SFXSoccer/ABCDEFC-Soccer-Robot/EAGLE/Projects 2019/2019 Soccer Robot/Gerber/CAMOutputs/Board 1/GerberFiles/Transcode Report.txt

   ---- Transcoding 'C:\Users\Marc\MEGA\RoboCup\2019\EAGLE\Projects 2019\2019 Soccer Robot\Gerber\CAMOutputs\GerberFiles\copper_top.gbr' ----   Tue Apr 16 15:44:12 2019

D10   --> D100
D11   --> D101
D12   --> D102
D13   --> D103
-----------------------------------------------------------------

   ---- Transcoding 'C:\Users\Marc\MEGA\RoboCup\2019\EAGLE\Projects 2019\2019 Soccer Robot\Gerber\CAMOutputs\GerberFiles\dimensions.gbr' ----   Tue Apr 16 15:44:12 2019

D10   --> D104
-----------------------------------------------------------------

   ---- Transcoding 'C:\Users\Marc\MEGA\RoboCup\2019\EAGLE\Projects 2019\2019 Soccer Robot\Gerber\CAMOutputs\GerberFiles\silkscreen_top.gbr' ----   Tue Apr 16 15:44:15 2019

D10   --> D105
D11   --> D106
D12   --> D107
D13   --> D108
D14   --> D109
D15   --> D110
D16   --> D111
D17   --> D112
D18   --> D113
D19   --> D114
D20   --> D115
D21   --> D116
D22   --> D117
D23   --> D118
D24   --> D119
D25   --> D120
D26   --> D121
-----------------------------------------------------------------

   ---- Transcoding 'C:\Users\Marc\MEGA\RoboCup\2019\EAGLE\Projects 2019\2019 Soccer Robot\Gerber\CAMOutputs\GerberFiles\soldermask_bottom.gbr' ----   Tue Apr 16 15:44:15 2019

D10   --> D122
D11   --> D123
D12   --> D124
D13   --> D125
D14   --> D126
-----------------------------------------------------------------

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

D10   --> D145
D11   --> D146
D12   --> D147
D13   --> D148
-----------------------------------------------------------------
