SFXSoccer/ABCDEFC-Soccer-Robot/EAGLE/Projects 2019/2019 Soccer Robot/Images/Board 1.png

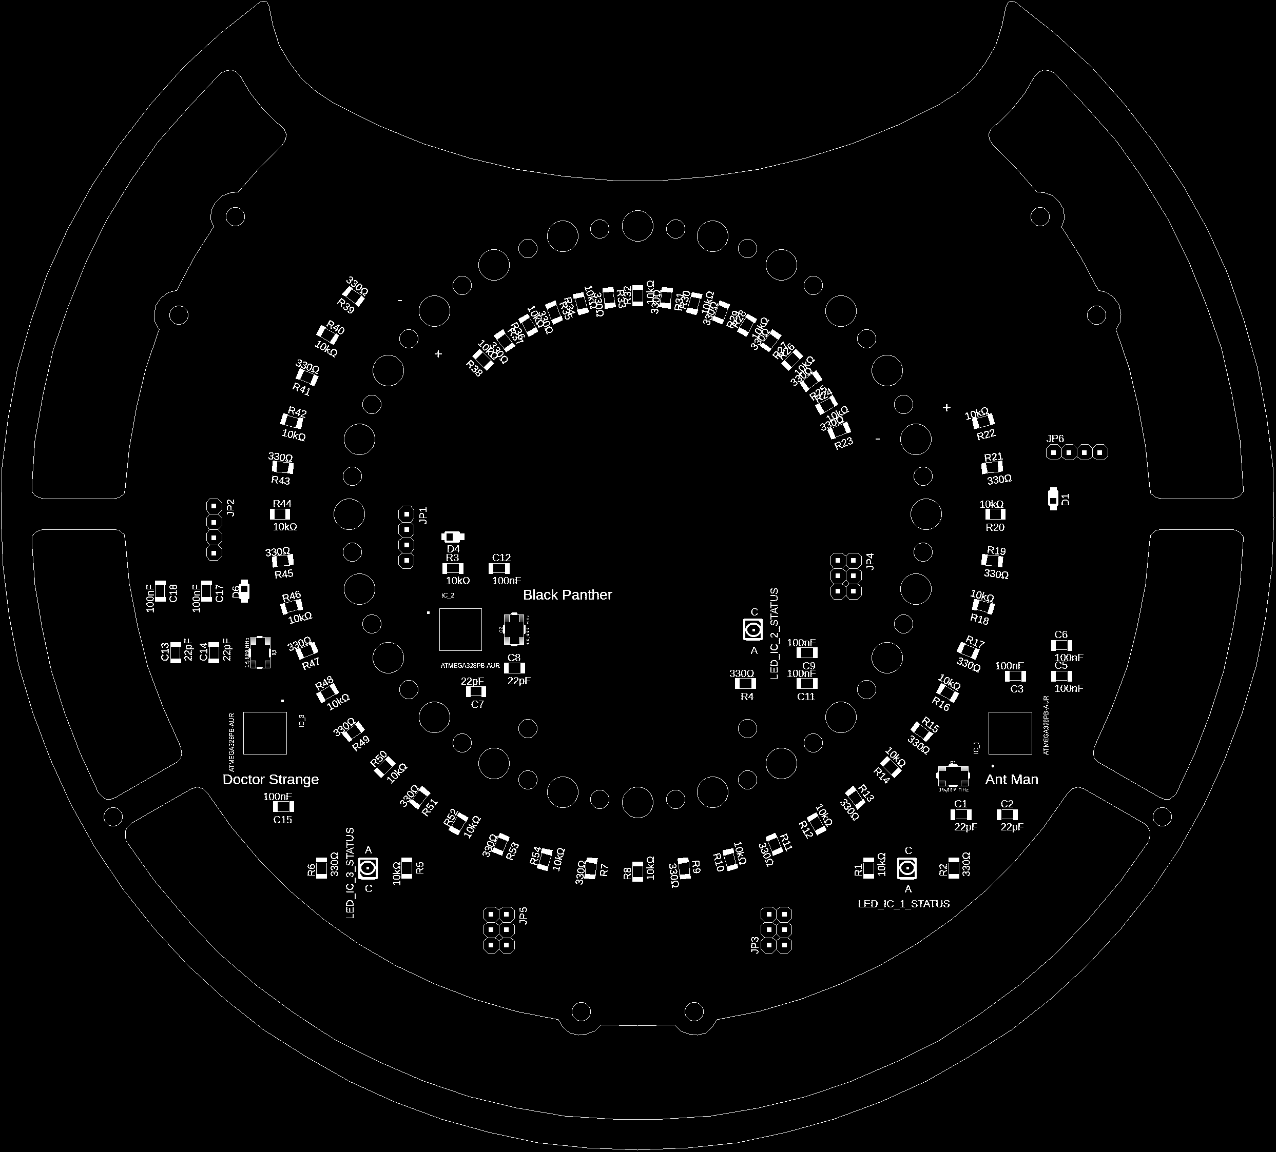
EAGLE/Projects 2019/2019 Soccer Robot/Images/Board 1.png
