SFXSoccer/ABCDEFC-Soccer-Robot/EAGLE/Projects 2019/2019 Soccer Robot/Images/Board 2.png

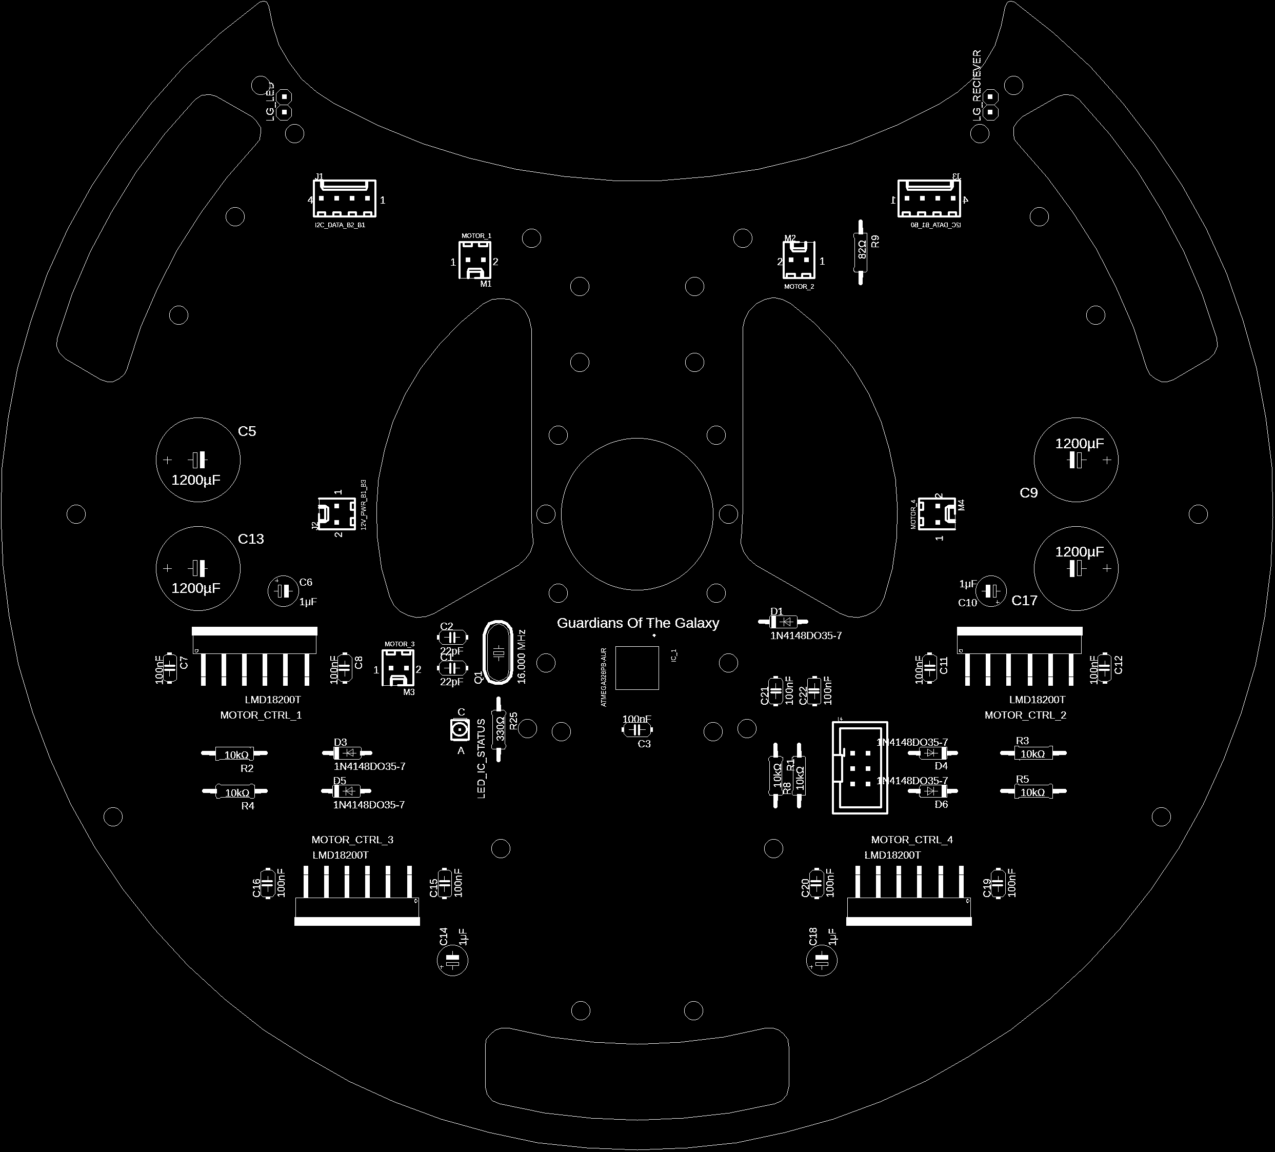
EAGLE/Projects 2019/2019 Soccer Robot/Images/Board 2.png
