SFXSoccer/ABCDEFC-Soccer-Robot/EAGLE/Projects 2019/2019 Soccer Robot/Images/Board 3.png

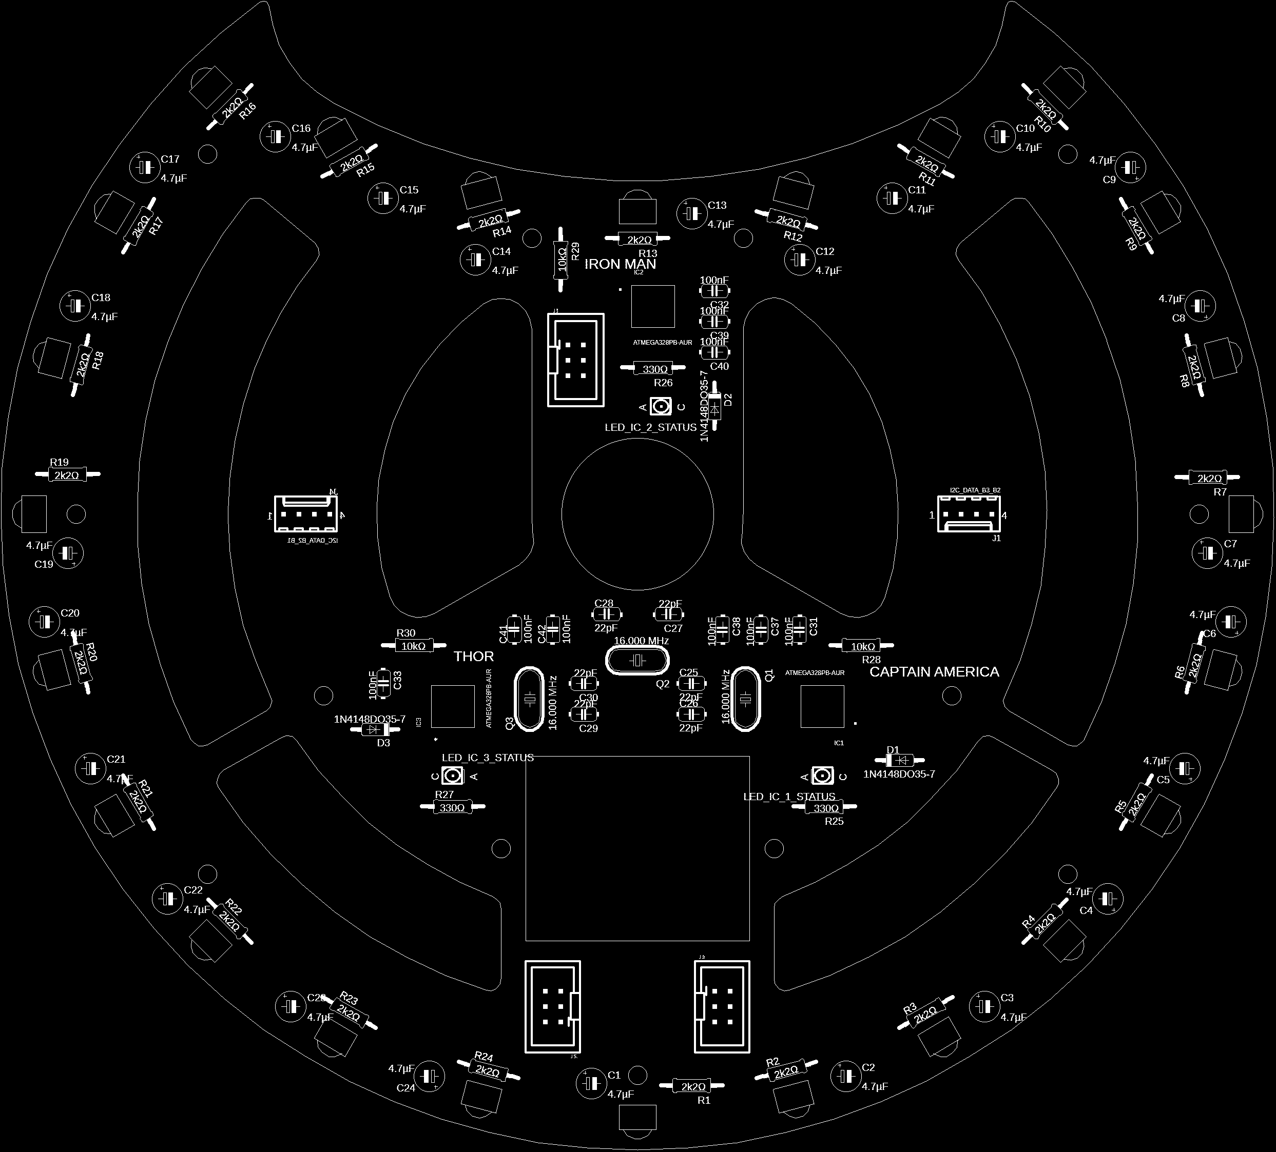
EAGLE/Projects 2019/2019 Soccer Robot/Images/Board 3.png
