SFXSoccer/ABCDEFC-Soccer-Robot/Programming/C#/RobotV2DiagnosticsTool/RobotV2DiagnosticsTool/Assets/Board 1.png

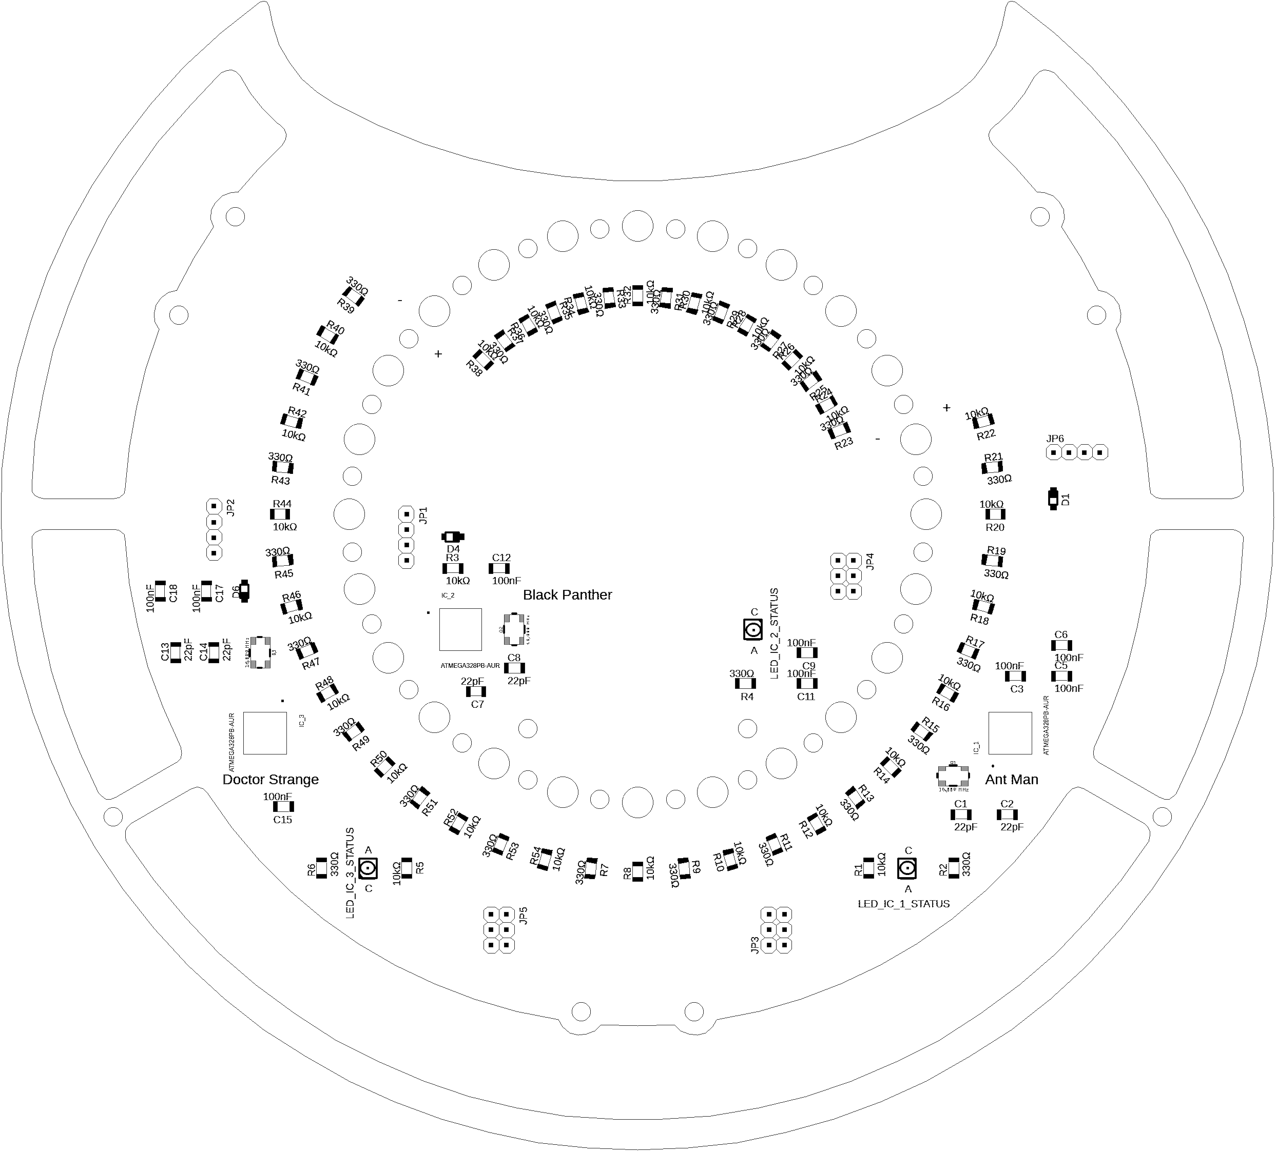
Programming/C#/RobotV2DiagnosticsTool/RobotV2DiagnosticsTool/Assets/Board 1.png
