SFXSoccer/ABCDEFC-Soccer-Robot/Programming/C#/RobotV2DiagnosticsTool/RobotV2DiagnosticsTool/Assets/Board 3.png

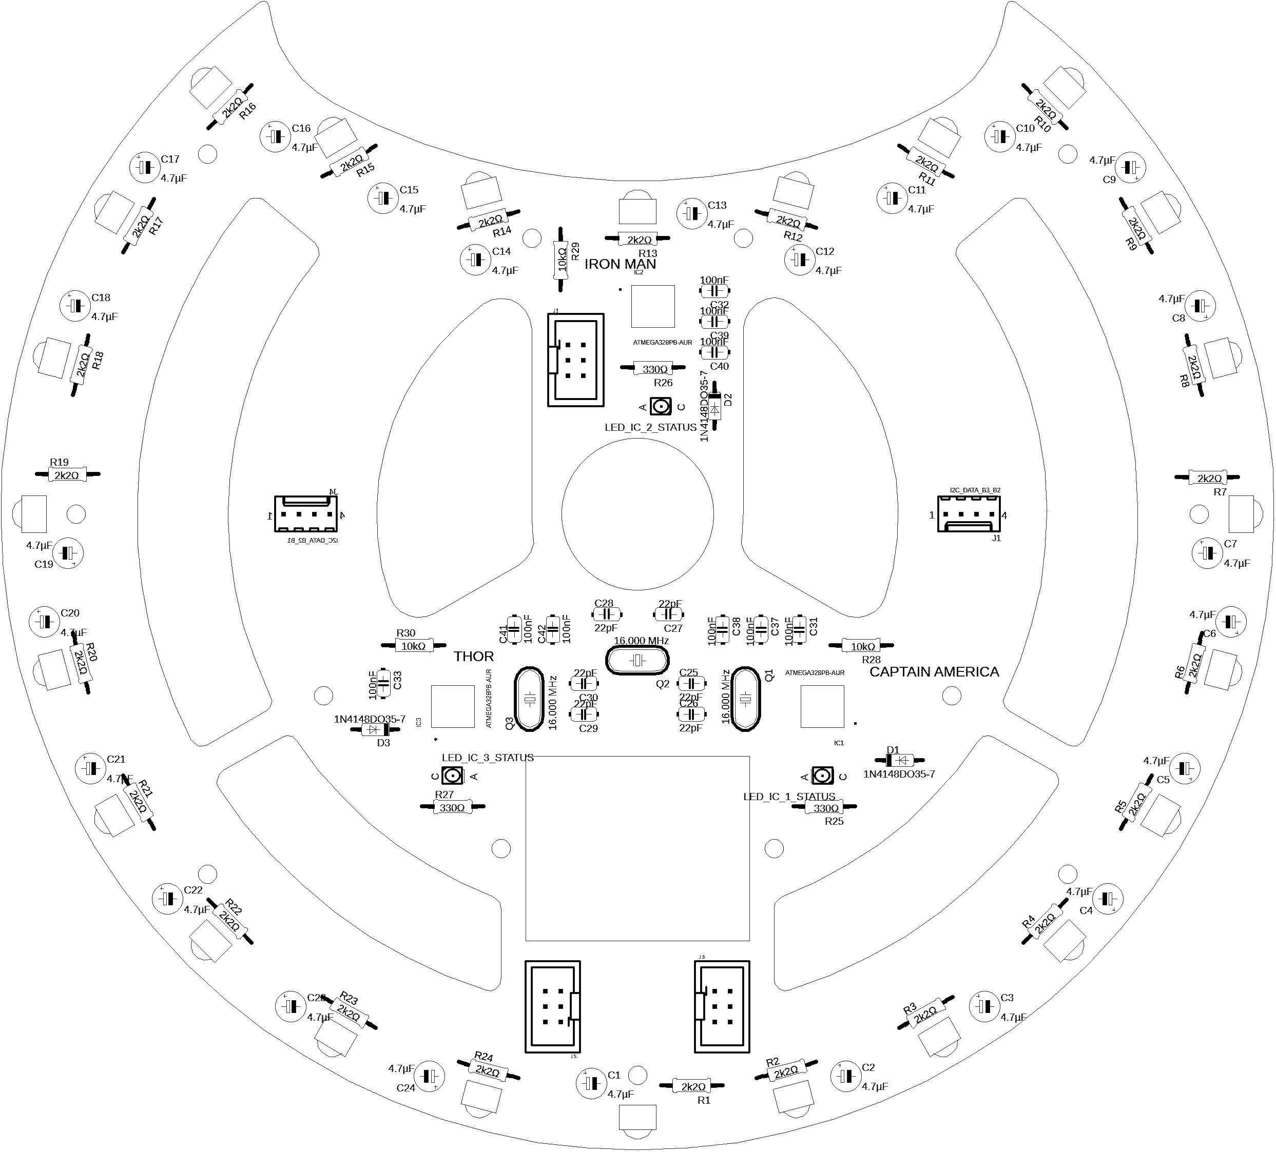
Programming/C#/RobotV2DiagnosticsTool/RobotV2DiagnosticsTool/Assets/Board 3.png
