SFXSoccer/ABCDEFC-Soccer-Robot/Programming/C#/RobotV2DiagnosticsTool/RobotV2DiagnosticsTool/Assets/Robot.png

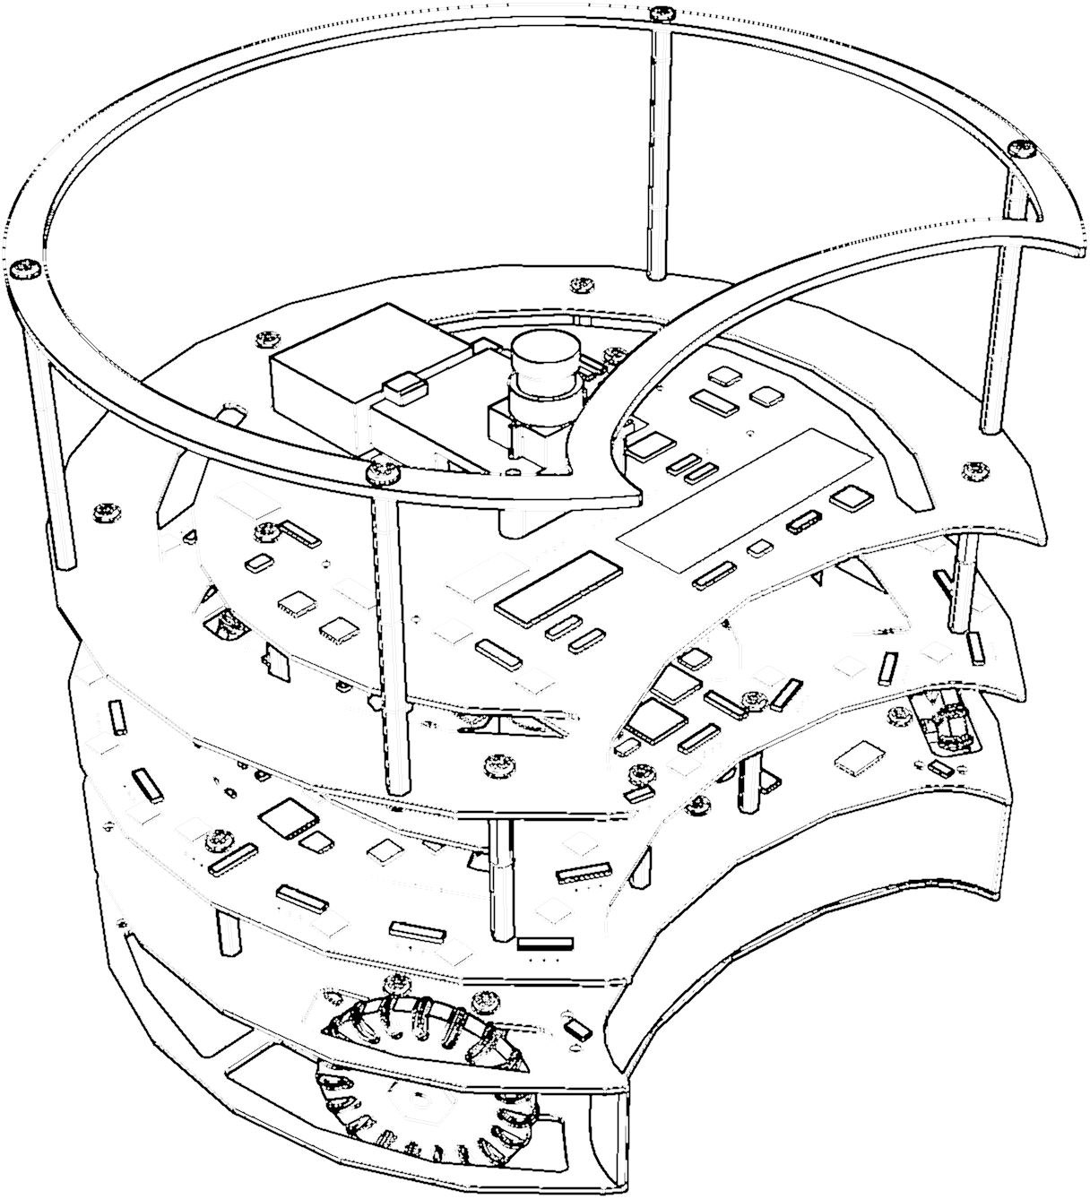
Programming/C#/RobotV2DiagnosticsTool/RobotV2DiagnosticsTool/Assets/Robot.png
