SFXSoccer/ABCDEFC-Soccer-Robot/EAGLE/DXF Files/Board 1.dxf

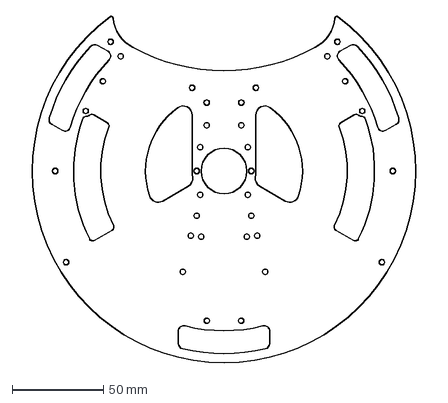
[picture p11: CAD file, 2019-07-01]
EAGLE/DXF Files/Board 1.dxf
227.8 x 189.7 mm
