SFXSoccer/ABCDEFC-Soccer-Robot/EAGLE/DXF Files/Board 0.dxf

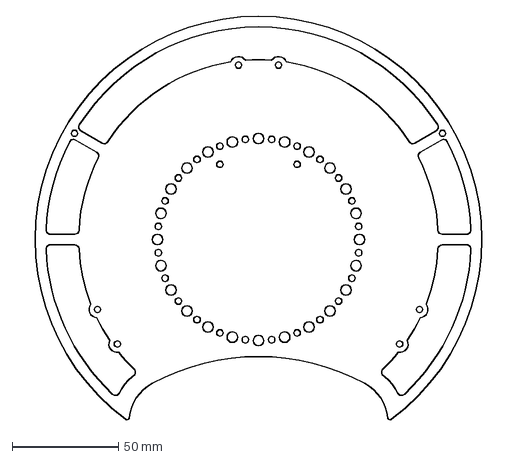
[picture p12: CAD file, 2019-07-01]
EAGLE/DXF Files/Board 0.dxf
227.8 x 189.7 mm
