SFXSoccer/ABCDEFC-Soccer-Robot/EAGLE/DXF Files/Camera PCB.dxf

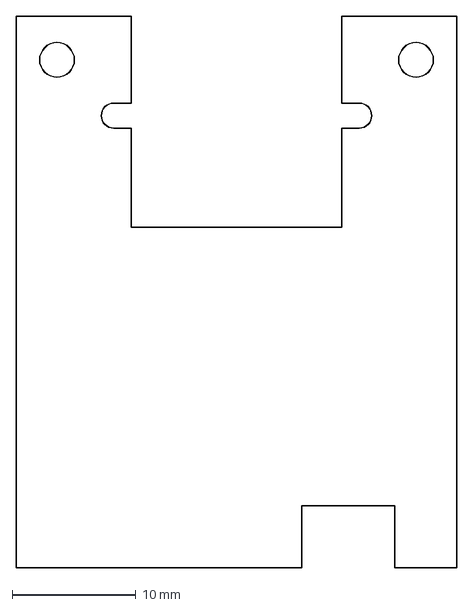
[picture p13: CAD file, 2019-07-01]
EAGLE/DXF Files/Camera PCB.dxf
35.6 x 44.5 mm
