SFXSoccer/ABCDEFC-Soccer-Robot/EAGLE/DXF Files/Camera Sensor Base.dxf

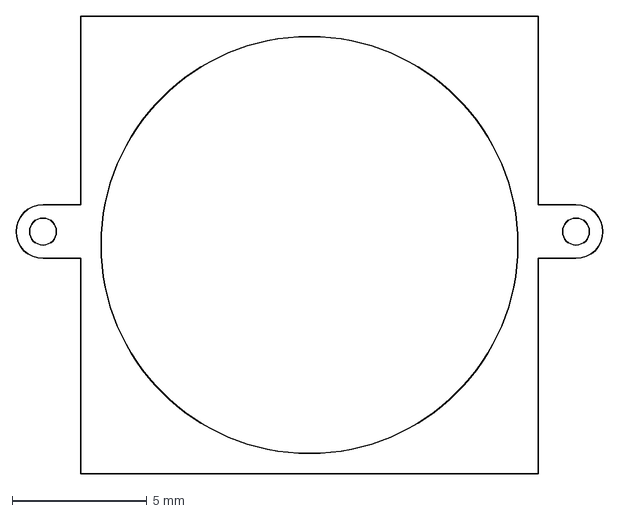
[picture p14: CAD file, 2019-07-01]
EAGLE/DXF Files/Camera Sensor Base.dxf
21.8 x 17.0 mm
