SFXSoccer/ABCDEFC-Soccer-Robot/EAGLE/DXF Files/Kicker Motor Mount.dxf

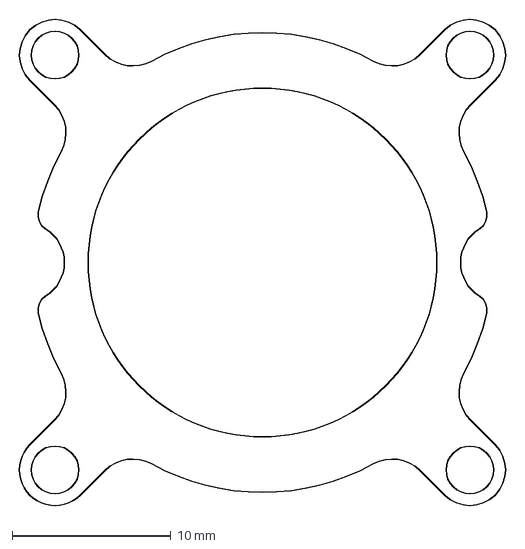
[picture p15: CAD file, 2019-07-01]
EAGLE/DXF Files/Kicker Motor Mount.dxf
31.1 x 31.1 mm
