SFXSoccer/ABCDEFC-Soccer-Robot/EAGLE/DXF Files/Battery Holder Base.dxf

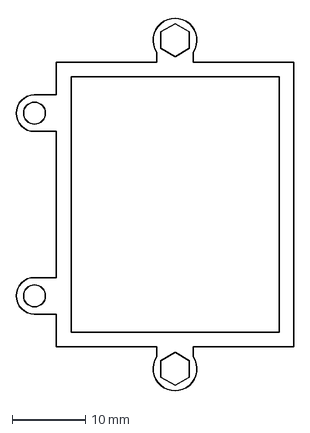
[picture p16: CAD file, 2019-07-01]
EAGLE/DXF Files/Battery Holder Base.dxf
38.0 x 51.5 mm
