SFXSoccer/ABCDEFC-Soccer-Robot/EAGLE/DXF Files/Board 2.dxf

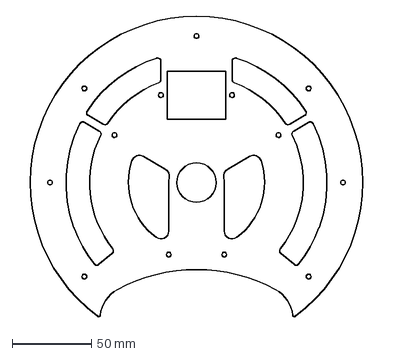
[picture p17: CAD file, 2019-07-01]
EAGLE/DXF Files/Board 2.dxf
227.8 x 189.7 mm
