SFXSoccer/ABCDEFC-Soccer-Robot/(list of files, cad)

Other CAD files:
EAGLE/Projects 2019/2019 Soccer Robot/IDF/Board 1/1X04SMD, JP1_1X04SMD_27.ipt
EAGLE/Projects 2019/2019 Soccer Robot/IDF/Board 1/1X04SMD, JP2_1X04SMD_29.ipt
EAGLE/Projects 2019/2019 Soccer Robot/IDF/Board 1/1X04SMD, JP6_1X04SMD_37.ipt
EAGLE/Projects 2019/2019 Soccer Robot/IDF/Board 1/2X03SMD, JP3_2X03SMD_31.ipt
EAGLE/Projects 2019/2019 Soccer Robot/IDF/Board 1/2X03SMD, JP4_2X03SMD_33.ipt
EAGLE/Projects 2019/2019 Soccer Robot/IDF/Board 1/2X03SMD, JP5_2X03SMD_35.ipt
EAGLE/Projects 2019/2019 Soccer Robot/IDF/Board 1/Board 0.brd.iam
EAGLE/Projects 2019/2019 Soccer Robot/IDF/Board 1/Board 0.brd_Outline.ipt
EAGLE/Projects 2019/2019 Soccer Robot/IDF/Board 1/C1206, C1206_1.ipt
EAGLE/Projects 2019/2019 Soccer Robot/IDF/Board 1/CRYSTAL-SMD-5X3_2-4PAD, 16_000_95.ipt
EAGLE/Projects 2019/2019 Soccer Robot/IDF/Board 1/P-LCC-2, LED_IC_1_STATUS_P-LCC-2_39.ipt
EAGLE/Projects 2019/2019 Soccer Robot/IDF/Board 1/P-LCC-2, LED_IC_2_STATUS_P-LCC-2_41.ipt
EAGLE/Projects 2019/2019 Soccer Robot/IDF/Board 1/P-LCC-2, LED_IC_3_STATUS_P-LCC-2_43.ipt
EAGLE/Projects 2019/2019 Soccer Robot/IDF/Board 1/QFP80P900X900X120-32N, ATMEGA328PB-AUR_23.ipt
EAGLE/Projects 2019/2019 Soccer Robot/IDF/Board 1/R1206, R1206_99.ipt
EAGLE/Projects 2019/2019 Soccer Robot/IDF/Board 1/SMD_LED_3MM, SMD_LED_3MM_45.ipt
EAGLE/Projects 2019/2019 Soccer Robot/IDF/Board 1/SMD_PHOTORESISTOR_5MM, SMD_PHOTORESISTOR_5MM_70.ipt
EAGLE/Projects 2019/2019 Soccer Robot/IDF/Board 1/SOD123, D1_SOD123_17.ipt
EAGLE/Projects 2019/2019 Soccer Robot/IDF/Board 1/SOD123, D4_SOD123_19.ipt
EAGLE/Projects 2019/2019 Soccer Robot/IDF/Board 1/SOD123, D6_SOD123_21.ipt
EAGLE/Projects 2019/2019 Soccer Robot/IDF/Board 2/0207_10, 0207_10_61.ipt
EAGLE/Projects 2019/2019 Soccer Robot/IDF/Board 2/1X02, 1X02_43.ipt
EAGLE/Projects 2019/2019 Soccer Robot/IDF/Board 2/2X3-SHROUDED, J4_2X3-SHROUDED_39.ipt
EAGLE/Projects 2019/2019 Soccer Robot/IDF/Board 2/6410-02, 12V_PWR_B1_B3_35.ipt
EAGLE/Projects 2019/2019 Soccer Robot/IDF/Board 2/6410-02, MOTOR_1_46.ipt
EAGLE/Projects 2019/2019 Soccer Robot/IDF/Board 2/6410-02, MOTOR_2_48.ipt
EAGLE/Projects 2019/2019 Soccer Robot/IDF/Board 2/6410-02, MOTOR_3_50.ipt
EAGLE/Projects 2019/2019 Soccer Robot/IDF/Board 2/6410-02, MOTOR_4_52.ipt
EAGLE/Projects 2019/2019 Soccer Robot/IDF/Board 2/6410-04, I2C_DATA_B1_B0_37.ipt
EAGLE/Projects 2019/2019 Soccer Robot/IDF/Board 2/6410-04, I2C_DATA_B2_B1_33.ipt
EAGLE/Projects 2019/2019 Soccer Robot/IDF/Board 2/Board 1.brd.iam
EAGLE/Projects 2019/2019 Soccer Robot/IDF/Board 2/Board 1.brd_Outline.ipt
EAGLE/Projects 2019/2019 Soccer Robot/IDF/Board 2/C050-024X044, C050-024X044_1.ipt
EAGLE/Projects 2019/2019 Soccer Robot/IDF/Board 2/DO35-7, 1N4148DO35-7_25.ipt
EAGLE/Projects 2019/2019 Soccer Robot/IDF/Board 2/E2-5, E2-5_7.ipt
EAGLE/Projects 2019/2019 Soccer Robot/IDF/Board 2/E5-13, E5-13_5.ipt
EAGLE/Projects 2019/2019 Soccer Robot/IDF/Board 2/HC49U-V, 16_000_59.ipt
EAGLE/Projects 2019/2019 Soccer Robot/IDF/Board 2/P-LCC-2, LED_IC_STATUS_P-LCC-2_41.ipt
EAGLE/Projects 2019/2019 Soccer Robot/IDF/Board 2/QFP80P900X900X120-32N, ATMEGA328PB-AUR_31.ipt
EAGLE/Projects 2019/2019 Soccer Robot/IDF/Board 2/TO-220-11, LMD18200T_54.ipt
EAGLE/Projects 2019/2019 Soccer Robot/IDF/Board 3/0207_10, 0207_10_70.ipt
EAGLE/Projects 2019/2019 Soccer Robot/IDF/Board 3/2X3-SHROUDED, J2_2X3-SHROUDED_52.ipt
EAGLE/Projects 2019/2019 Soccer Robot/IDF/Board 3/2X3-SHROUDED, J3_2X3-SHROUDED_54.ipt
EAGLE/Projects 2019/2019 Soccer Robot/IDF/Board 3/2X3-SHROUDED, J5_2X3-SHROUDED_58.ipt
EAGLE/Projects 2019/2019 Soccer Robot/IDF/Board 3/6410-04, I2C_DATA_B2_B1_56.ipt
EAGLE/Projects 2019/2019 Soccer Robot/IDF/Board 3/6410-04, I2C_DATA_B3_B2_50.ipt
EAGLE/Projects 2019/2019 Soccer Robot/IDF/Board 3/Board 2.brd.iam
EAGLE/Projects 2019/2019 Soccer Robot/IDF/Board 3/Board 2.brd_Outline.ipt
EAGLE/Projects 2019/2019 Soccer Robot/IDF/Board 3/C050-024X044, C050-024X044_26.ipt
EAGLE/Projects 2019/2019 Soccer Robot/IDF/Board 3/DO35-7, 1N4148DO35-7_42.ipt
EAGLE/Projects 2019/2019 Soccer Robot/IDF/Board 3/E2-5, E2-5_1.ipt
EAGLE/Projects 2019/2019 Soccer Robot/IDF/Board 3/HC49U-V, 16_000_66.ipt
EAGLE/Projects 2019/2019 Soccer Robot/IDF/Board 3/P-LCC-2, LED_IC_1_STATUS_P-LCC-2_60.ipt
EAGLE/Projects 2019/2019 Soccer Robot/IDF/Board 3/P-LCC-2, LED_IC_2_STATUS_P-LCC-2_62.ipt
EAGLE/Projects 2019/2019 Soccer Robot/IDF/Board 3/P-LCC-2, LED_IC_3_STATUS_P-LCC-2_64.ipt
EAGLE/Projects 2019/2019 Soccer Robot/IDF/Board 3/QFP80P900X900X120-32N, ATMEGA328PB-AUR_46.ipt
EAGLE/Projects 2019/2019 Soccer Robot/IDF/Board 3/TSOP143XX, TSOP14340_101.ipt
EAGLE/Projects 2019/2019 Soccer Robot/IDF/Board 4/0207_10, 0207_10_44.ipt
EAGLE/Projects 2019/2019 Soccer Robot/IDF/Board 4/0207_9, 10K_50.ipt
EAGLE/Projects 2019/2019 Soccer Robot/IDF/Board 4/0207_9, 4K7_47.ipt
EAGLE/Projects 2019/2019 Soccer Robot/IDF/Board 4/1X04, 1X04_17.ipt
EAGLE/Projects 2019/2019 Soccer Robot/IDF/Board 4/1X08, 1X08_14.ipt
EAGLE/Projects 2019/2019 Soccer Robot/IDF/Board 4/6410-02, 12V_POWER_32.ipt
EAGLE/Projects 2019/2019 Soccer Robot/IDF/Board 4/6410-02, KICKER_ENCODER_36.ipt
EAGLE/Projects 2019/2019 Soccer Robot/IDF/Board 4/6410-04, I2C_DATA_B3_B2_28.ipt
EAGLE/Projects 2019/2019 Soccer Robot/IDF/Board 4/6410-04, LIDAR_34.ipt
EAGLE/Projects 2019/2019 Soccer Robot/IDF/Board 4/6410-04, MAG_ACC_I2C_26.ipt
EAGLE/Projects 2019/2019 Soccer Robot/IDF/Board 4/6410-05, LED_MATRIX_30.ipt
EAGLE/Projects 2019/2019 Soccer Robot/IDF/Board 4/78XXS, IC1_78XXS_22.ipt
EAGLE/Projects 2019/2019 Soccer Robot/IDF/Board 4/78XXS, IC2_78XXS_24.ipt
EAGLE/Projects 2019/2019 Soccer Robot/IDF/Board 4/B3F-10XX, BUTTON0_B3F-10XX_1.ipt
EAGLE/Projects 2019/2019 Soccer Robot/IDF/Board 4/B3F-10XX, BUTTON1_B3F-10XX_3.ipt
EAGLE/Projects 2019/2019 Soccer Robot/IDF/Board 4/B3F-10XX, BUTTON2_B3F-10XX_5.ipt
EAGLE/Projects 2019/2019 Soccer Robot/IDF/Board 4/B3F-10XX, BUTTON3_B3F-10XX_7.ipt
EAGLE/Projects 2019/2019 Soccer Robot/IDF/Board 4/B3F-10XX, RESET_B3F-10XX_57.ipt
EAGLE/Projects 2019/2019 Soccer Robot/IDF/Board 4/Board 3 Teensy.brd.iam
EAGLE/Projects 2019/2019 Soccer Robot/IDF/Board 4/Board 3 Teensy.brd_Outline.ipt
EAGLE/Projects 2019/2019 Soccer Robot/IDF/Board 4/DO35-7, 1N4148DO35-7_19.ipt
EAGLE/Projects 2019/2019 Soccer Robot/IDF/Board 4/E2-5, E2-5_9.ipt
EAGLE/Projects 2019/2019 Soccer Robot/IDF/Board 4/OldVersions/Board 3 Teensy.brd.0001.iam
EAGLE/Projects 2019/2019 Soccer Robot/IDF/Board 4/P-LCC-2, LED_5V_0_P-LCC-2_38.ipt
EAGLE/Projects 2019/2019 Soccer Robot/IDF/Board 4/P-LCC-2, LED_5V_1_P-LCC-2_40.ipt
EAGLE/Projects 2019/2019 Soccer Robot/IDF/Board 4/P-LCC-2, LED_IC_1_STATUS_P-LCC-2_42.ipt
EAGLE/Projects 2019/2019 Soccer Robot/IDF/Board 4/SCHALTER, SCHALTER_68.ipt
EAGLE/Projects 2019/2019 Soccer Robot/IDF/Board 4/SICHERUNG, SICHERUNG_59.ipt
EAGLE/Projects 2019/2019 Soccer Robot/IDF/Board 4/STAND-OFF, STAND-OFF_65.ipt
EAGLE/Projects 2019/2019 Soccer Robot/IDF/Board 4/TEENSY_3_5_ALL_PINS, TEENSY_3_5_ALL_PINS_63.ipt
EAGLE/Projects 2019/2019 Soccer Robot/IDF/Board 4/XT60, XT60_61.ipt
Inventor/15mmStandoff.ipt
Inventor/19mmStandoff.ipt
Inventor/1stPlate.ipt
Inventor/2ndPlate.ipt
Inventor/2x6mmScrew.ipt
Inventor/3rdFront.ipt
Inventor/3rdPlate.ipt
Inventor/3rdShroud.ipt
Inventor/4thPlate.ipt
Inventor/50mm OmniWheel Mockup.ipt
Inventor/5mmScrew.ipt
Inventor/730RPM Motor Mockup.ipt
Inventor/8mmStandoff.ipt
Inventor/Handle.ipt
Inventor/IRShroudV2.ipt
Inventor/LightGate.ipt
Inventor/MirrorMountTest.ipt
Inventor/Motor&MotorMount.iam
Inventor/MotorMountv2.ipt
Inventor/OldVersions/IRShroudV2.0001.ipt
Inventor/OldVersions/WholeRobotAssembly.0002.iam
Inventor/WholeRobotAssembly.iam
