SFXSoccer/ABCDEFC-Soccer-Robot/EAGLE/Projects 2019/2019 Soccer Robot/Board 2.brd

## EAGLE design EAGLE/Projects 2019/2019 Soccer Robot/Board 2.brd (2019-07-01)

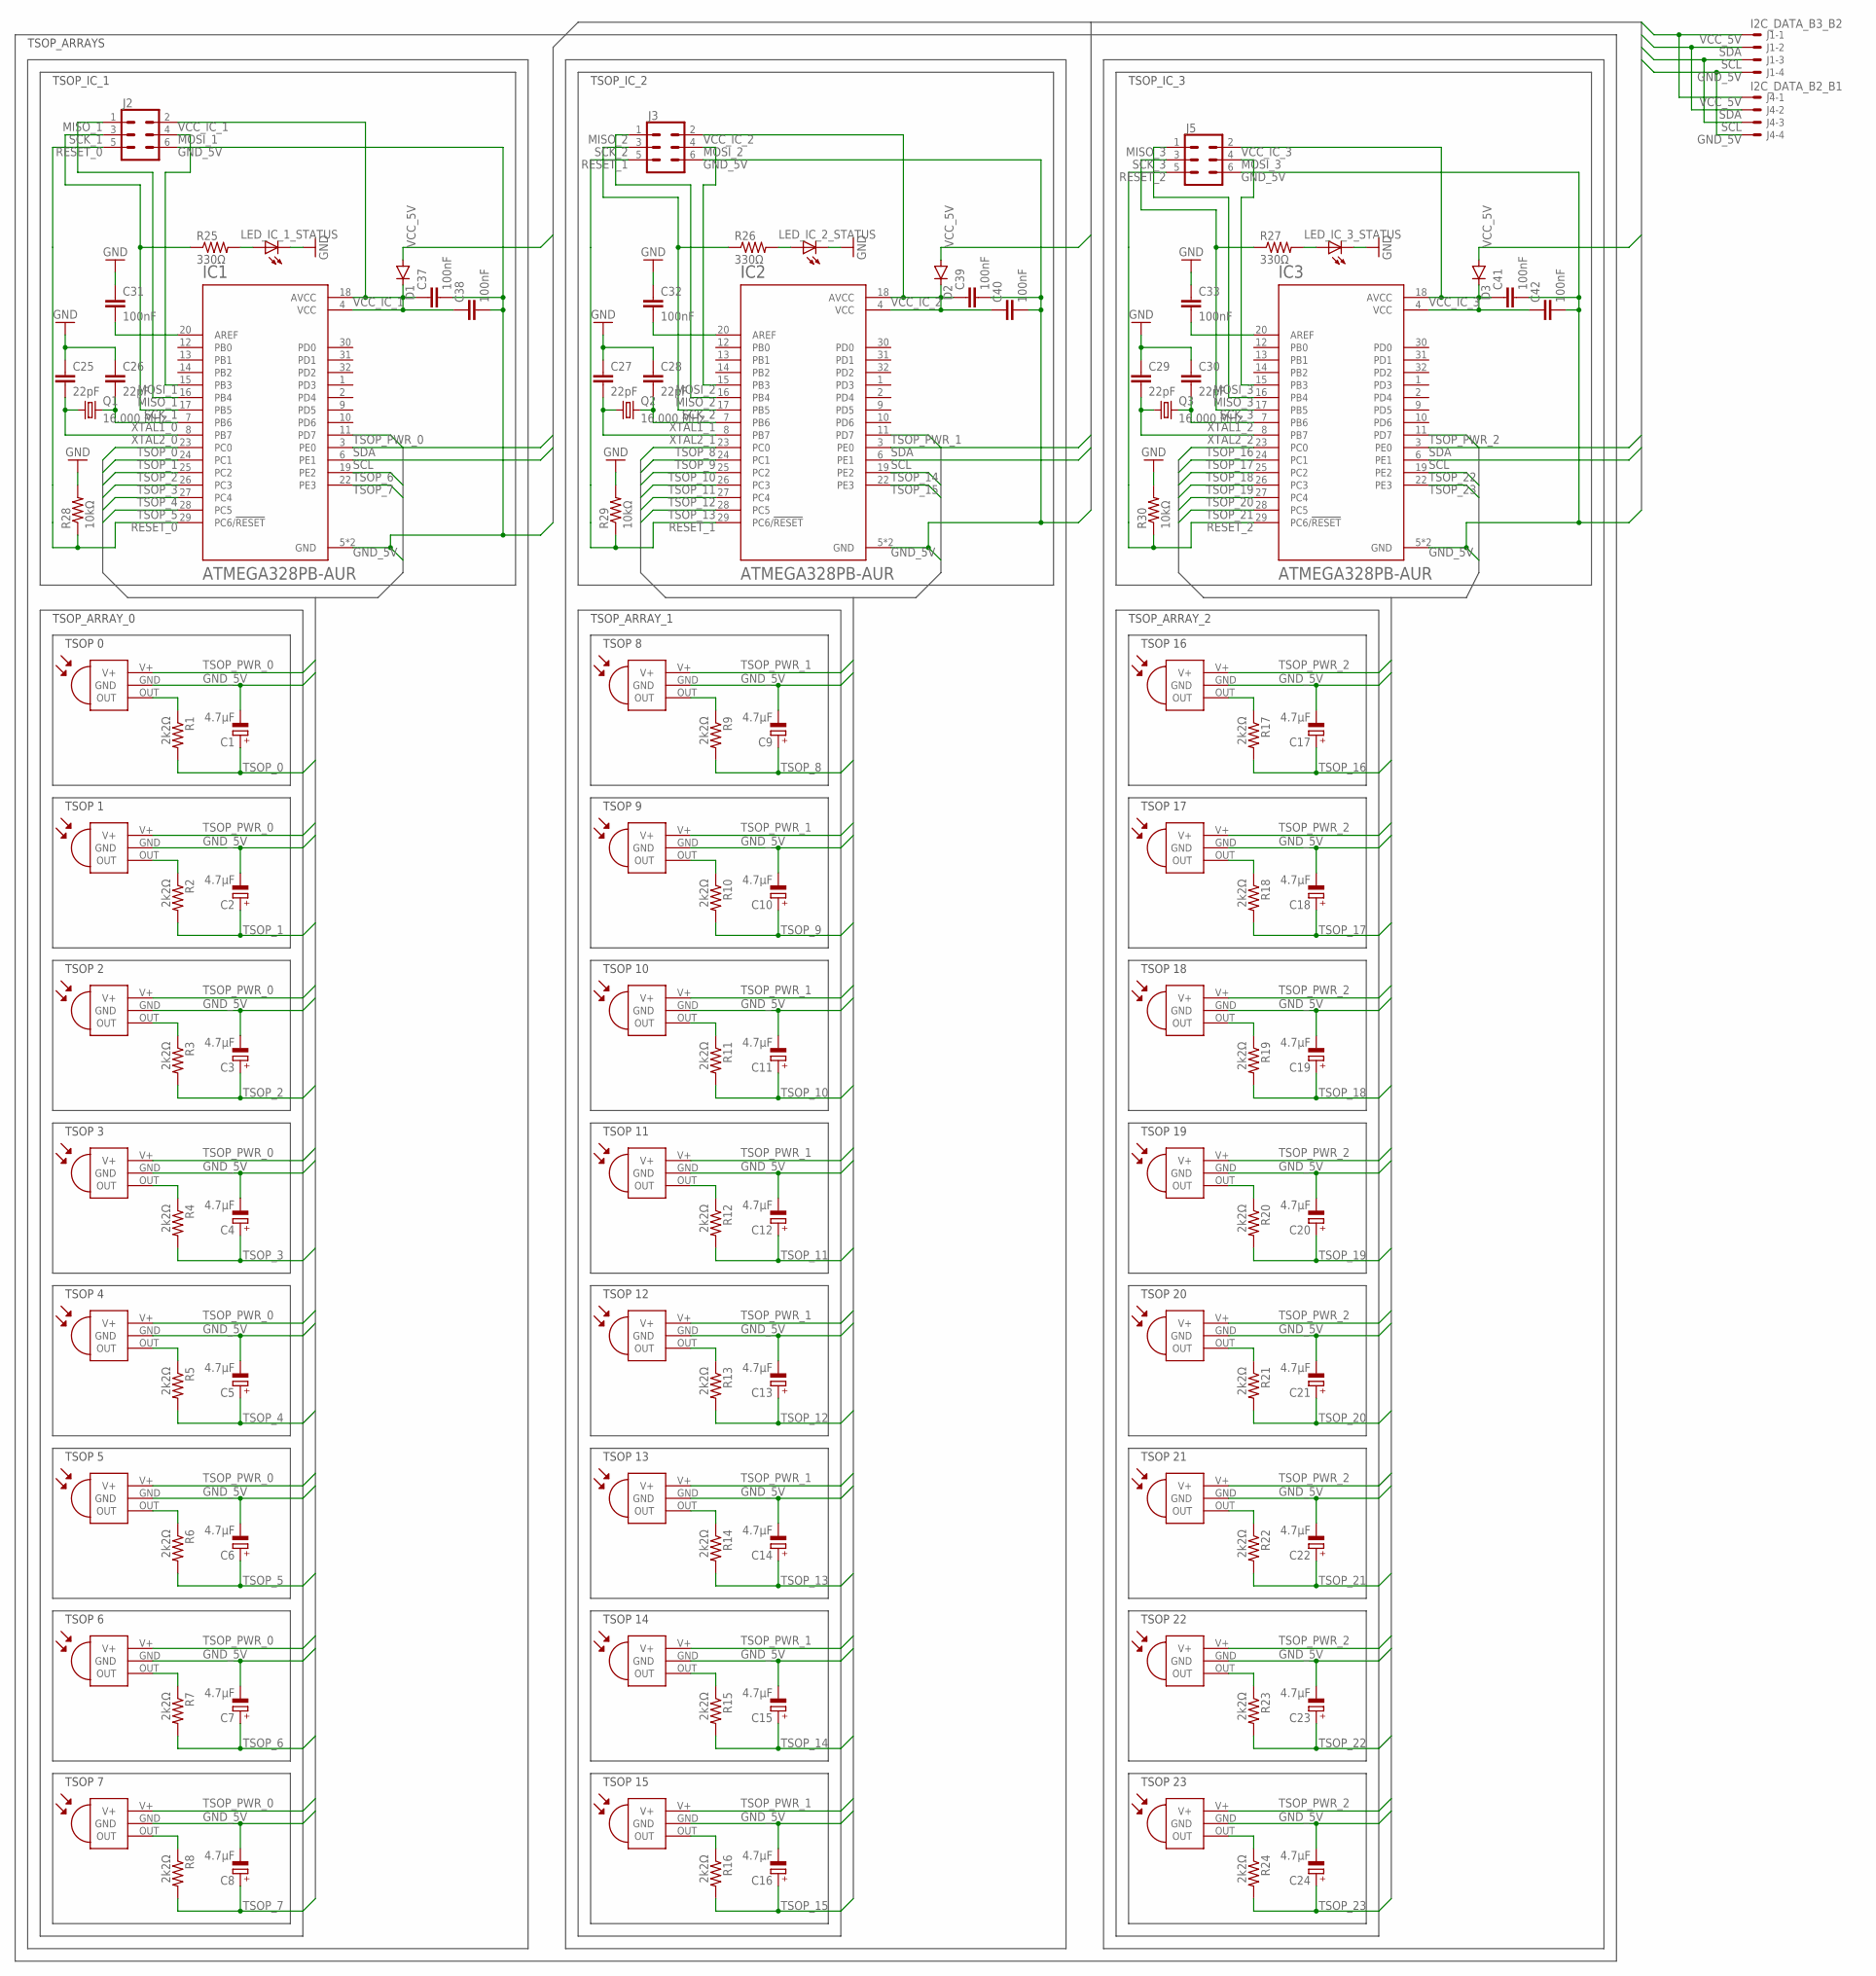
[picture p18: schematic Board 2.sch]

Parts:
C1, C2, C3, C4, C5, C6, C7, C8, C9, C10, C11, C12, C13, C14, C15, C16, C17, C18, C19, C20, C21, C22, C23, C24: 4.7µF; E2-5
C25, C26, C27, C28, C29, C30: 22pF; C050-024X044
C31, C32, C33, C37, C38, C39, C40, C41, C42: 100nF; C050-024X044
D1, D2, D3: 1N4148DO35-7; DO35-7
IC1, IC2, IC3: ATMEGA328PB-AUR; QFP80P900X900X120-32N
J1: I2C_DATA_B3_B2; 6410-04
J2, J3, J5: CONN_03X2SHROUD; 2X3-SHROUDED
J4: I2C_DATA_B2_B1; 6410-04
LED_IC_1_STATUS, LED_IC_2_STATUS, LED_IC_3_STATUS: LEDP-LCC-2; P-LCC-2
Q1, Q2, Q3: 16.000 MHz; HC49U-V
R1, R2, R3, R4, R5, R6, R7, R8, R9, R10, R11, R12, R13, R14, R15, R16, R17, R18, R19, R20, R21, R22, R23, R24: 2k2Ω; 0207/10
R25, R26, R27: 330Ω; 0207/10
R28, R29, R30: 10kΩ; 0207/10
TSOP_1, TSOP_2, TSOP_3, TSOP_4, TSOP_5, TSOP_6, TSOP_7, TSOP_8, TSOP_9, TSOP_10, TSOP_11, TSOP_12, TSOP_13, TSOP_14, TSOP_15, TSOP_16, TSOP_17, TSOP_18, TSOP_19, TSOP_20, TSOP_21, TSOP_22, TSOP_23, TSOP_24: TSOP14340; TSOP143XX

Connections:
GND_5V: C1.-, C2.-, C3.-, C4.-, C5.-, C6.-, C7.-, C8.-, C9.-, C10.-, C11.-, C12.-, C13.-, C14.-, C15.-, C16.-, C17.-, C18.-, C19.-, C20.-, C21.-, C22.-, C23.-, C24.-, C25.1, C26.1, C27.1, C28.1, C29.1, C30.1, C31.1, C32.1, C33.1, C37.2, C38.2, C39.2, C40.2, C41.2, C42.2, IC1.5 (GND), IC1.21 (GND), IC2.5 (GND), IC2.21 (GND), IC3.5 (GND), IC3.21 (GND), J1.4, J2.6, J3.6, J4.4, J5.6, LED_IC_1_STATUS.C, LED_IC_2_STATUS.C, LED_IC_3_STATUS.C, R28.2, R29.2, R30.2, TSOP_1.GND, TSOP_2.GND, TSOP_3.GND, TSOP_4.GND, TSOP_5.GND, TSOP_6.GND, TSOP_7.GND, TSOP_8.GND, TSOP_9.GND, TSOP_10.GND, TSOP_11.GND, TSOP_12.GND, TSOP_13.GND, TSOP_14.GND, TSOP_15.GND, TSOP_16.GND, TSOP_17.GND, TSOP_18.GND, TSOP_19.GND, TSOP_20.GND, TSOP_21.GND, TSOP_22.GND, TSOP_23.GND, TSOP_24.GND
MISO_1: IC1.16 (PB4), J2.1
MISO_2: IC2.16 (PB4), J3.1
MISO_3: IC3.16 (PB4), J5.1
MOSI_1: IC1.15 (PB3), J2.4
MOSI_2: IC2.15 (PB3), J3.4
MOSI_3: IC3.15 (PB3), J5.4
unnamed: R1.1, TSOP_1.OUT
unnamed: R2.1, TSOP_2.OUT
unnamed: R3.1, TSOP_3.OUT
unnamed: R4.1, TSOP_4.OUT
unnamed: R5.1, TSOP_5.OUT
unnamed: R6.1, TSOP_6.OUT
unnamed: R7.1, TSOP_7.OUT
unnamed: R8.1, TSOP_8.OUT
unnamed: R9.1, TSOP_9.OUT
unnamed: R10.1, TSOP_10.OUT
unnamed: R11.1, TSOP_11.OUT
unnamed: R12.1, TSOP_12.OUT
unnamed: R13.1, TSOP_13.OUT
unnamed: R14.1, TSOP_14.OUT
unnamed: R15.1, TSOP_15.OUT
unnamed: R16.1, TSOP_16.OUT
unnamed: R17.1, TSOP_17.OUT
unnamed: R18.1, TSOP_18.OUT
unnamed: R19.1, TSOP_19.OUT
unnamed: R20.1, TSOP_20.OUT
unnamed: R21.1, TSOP_21.OUT
unnamed: R22.1, TSOP_22.OUT
unnamed: R23.1, TSOP_23.OUT
unnamed: R24.1, TSOP_24.OUT
unnamed: LED_IC_1_STATUS.A, R25.2
unnamed: C31.2, IC1.20 (AREF)
unnamed: LED_IC_2_STATUS.A, R26.2
unnamed: C32.2, IC2.20 (AREF)
unnamed: LED_IC_3_STATUS.A, R27.2
unnamed: C33.2, IC3.20 (AREF)
RESET_0: IC1.29 (PC6/!RESET), J2.5, R28.1
RESET_1: IC2.29 (PC6/!RESET), J3.5, R29.1
RESET_2: IC3.29 (PC6/!RESET), J5.5, R30.1
SCK_1: IC1.17 (PB5), J2.3, R25.1
SCK_2: IC2.17 (PB5), J3.3, R26.1
SCK_3: IC3.17 (PB5), J5.3, R27.1
SCL: IC1.6 (PE1), IC2.6 (PE1), IC3.6 (PE1), J1.3, J4.3
SDA: IC1.3 (PE0), IC2.3 (PE0), IC3.3 (PE0), J1.2, J4.2
TSOP_0: C1.+, IC1.23 (PC0), R1.2
TSOP_1: C2.+, IC1.24 (PC1), R2.2
TSOP_2: C3.+, IC1.25 (PC2), R3.2
TSOP_3: C4.+, IC1.26 (PC3), R4.2
TSOP_4: C5.+, IC1.27 (PC4), R5.2
TSOP_5: C6.+, IC1.28 (PC5), R6.2
TSOP_6: C7.+, IC1.19 (PE2), R7.2
TSOP_7: C8.+, IC1.22 (PE3), R8.2
TSOP_8: C9.+, IC2.23 (PC0), R9.2
TSOP_9: C10.+, IC2.24 (PC1), R10.2
TSOP_10: C11.+, IC2.25 (PC2), R11.2
TSOP_11: C12.+, IC2.26 (PC3), R12.2
TSOP_12: C13.+, IC2.27 (PC4), R13.2
TSOP_13: C14.+, IC2.28 (PC5), R14.2
TSOP_14: C15.+, IC2.19 (PE2), R15.2
TSOP_15: C16.+, IC2.22 (PE3), R16.2
TSOP_16: C17.+, IC3.23 (PC0), R17.2
TSOP_17: C18.+, IC3.24 (PC1), R18.2
TSOP_18: C19.+, IC3.25 (PC2), R19.2
TSOP_19: C20.+, IC3.26 (PC3), R20.2
TSOP_20: C21.+, IC3.27 (PC4), R21.2
TSOP_21: C22.+, IC3.28 (PC5), R22.2
TSOP_22: C23.+, IC3.19 (PE2), R23.2
TSOP_23: C24.+, IC3.22 (PE3), R24.2
TSOP_PWR_0: IC1.11 (PD7), TSOP_1.V+, TSOP_2.V+, TSOP_3.V+, TSOP_4.V+, TSOP_5.V+, TSOP_6.V+, TSOP_7.V+, TSOP_8.V+
TSOP_PWR_1: IC2.11 (PD7), TSOP_9.V+, TSOP_10.V+, TSOP_11.V+, TSOP_12.V+, TSOP_13.V+, TSOP_14.V+, TSOP_15.V+, TSOP_16.V+
TSOP_PWR_2: IC3.11 (PD7), TSOP_17.V+, TSOP_18.V+, TSOP_19.V+, TSOP_20.V+, TSOP_21.V+, TSOP_22.V+, TSOP_23.V+, TSOP_24.V+
VCC_5V: D1.A, D2.A, D3.A, J1.1, J4.1
VCC_IC_1: C37.1, C38.1, D1.C, IC1.4 (VCC), IC1.18 (AVCC), J2.2
VCC_IC_2: C39.1, C40.1, D2.C, IC2.4 (VCC), IC2.18 (AVCC), J3.2
VCC_IC_3: C41.1, C42.1, D3.C, IC3.4 (VCC), IC3.18 (AVCC), J5.2
XTAL1_0: C26.2, IC1.7 (PB6), Q1.2
XTAL1_1: C28.2, IC2.7 (PB6), Q2.2
XTAL1_2: C30.2, IC3.7 (PB6), Q3.2
XTAL2_0: C25.2, IC1.8 (PB7), Q1.1
XTAL2_1: C27.2, IC2.8 (PB7), Q2.1
XTAL2_2: C29.2, IC3.8 (PB7), Q3.1

Notes on the sheet:
TSOP 0
TSOP 1
TSOP 2
TSOP 3
TSOP 4
TSOP 5
TSOP 6
TSOP 7
TSOP 8
TSOP 9
TSOP 10
TSOP 11
TSOP 12
TSOP 13
TSOP 14
TSOP 15
TSOP 16
TSOP 17
TSOP 18
TSOP 19
TSOP 20
TSOP 21
TSOP 22
TSOP 23
TSOP_IC_1
TSOP_IC_2
TSOP_IC_3
TSOP_ARRAY_0
TSOP_ARRAY_1
TSOP_ARRAY_2
TSOP_ARRAYS

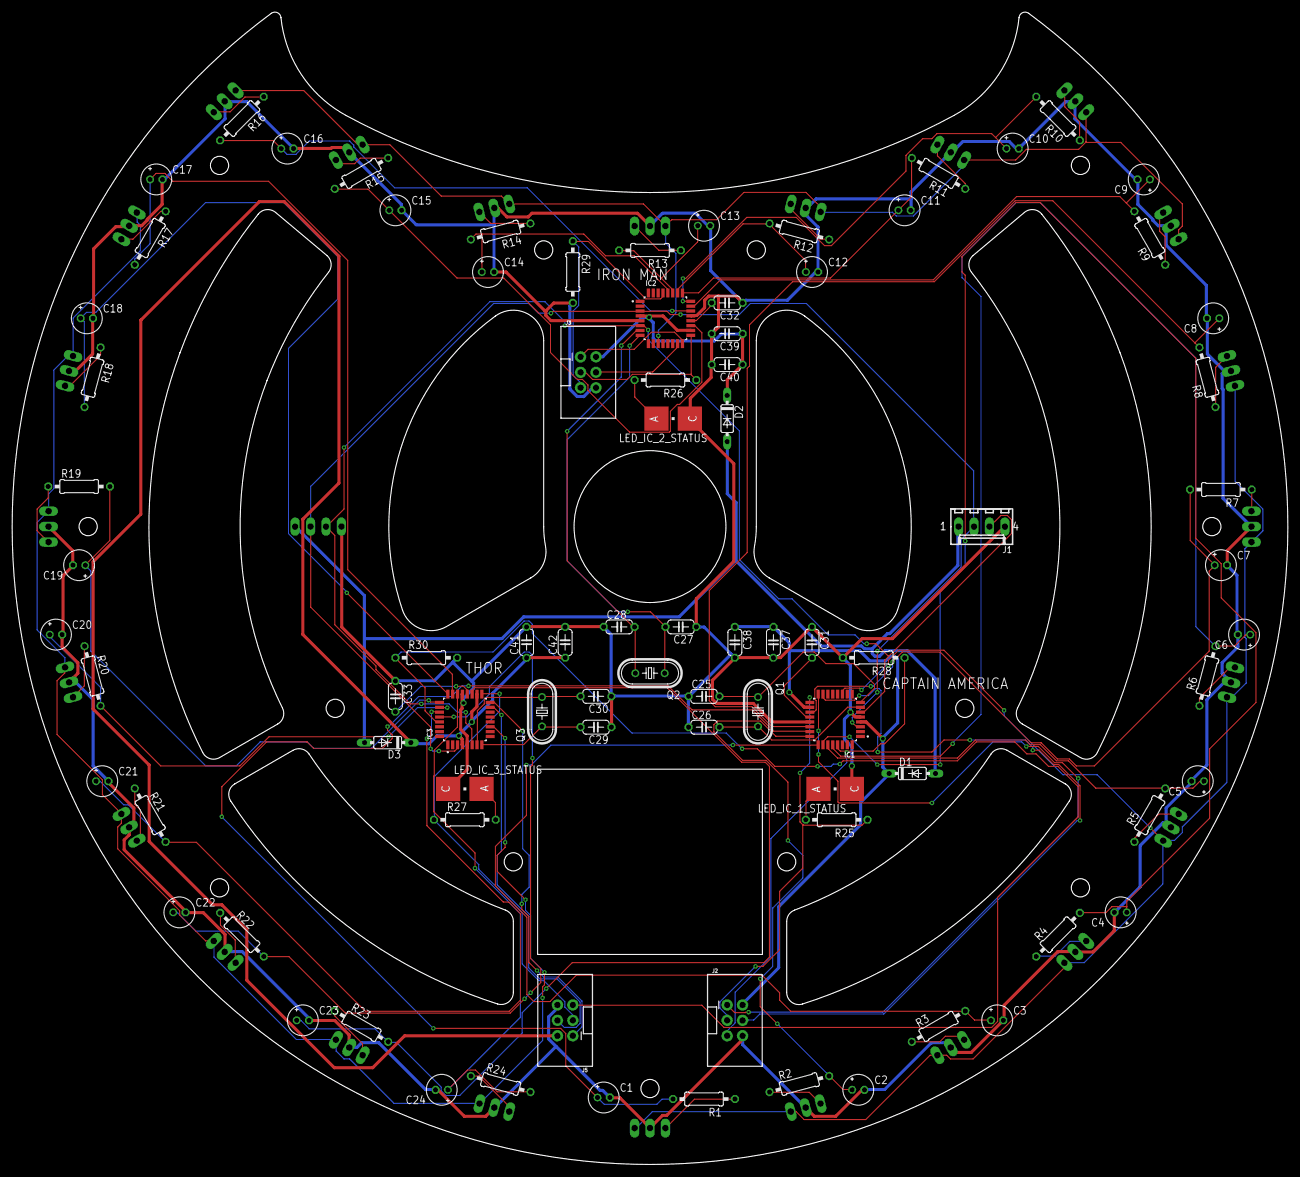
[picture p19: board Board 2.brd from above]

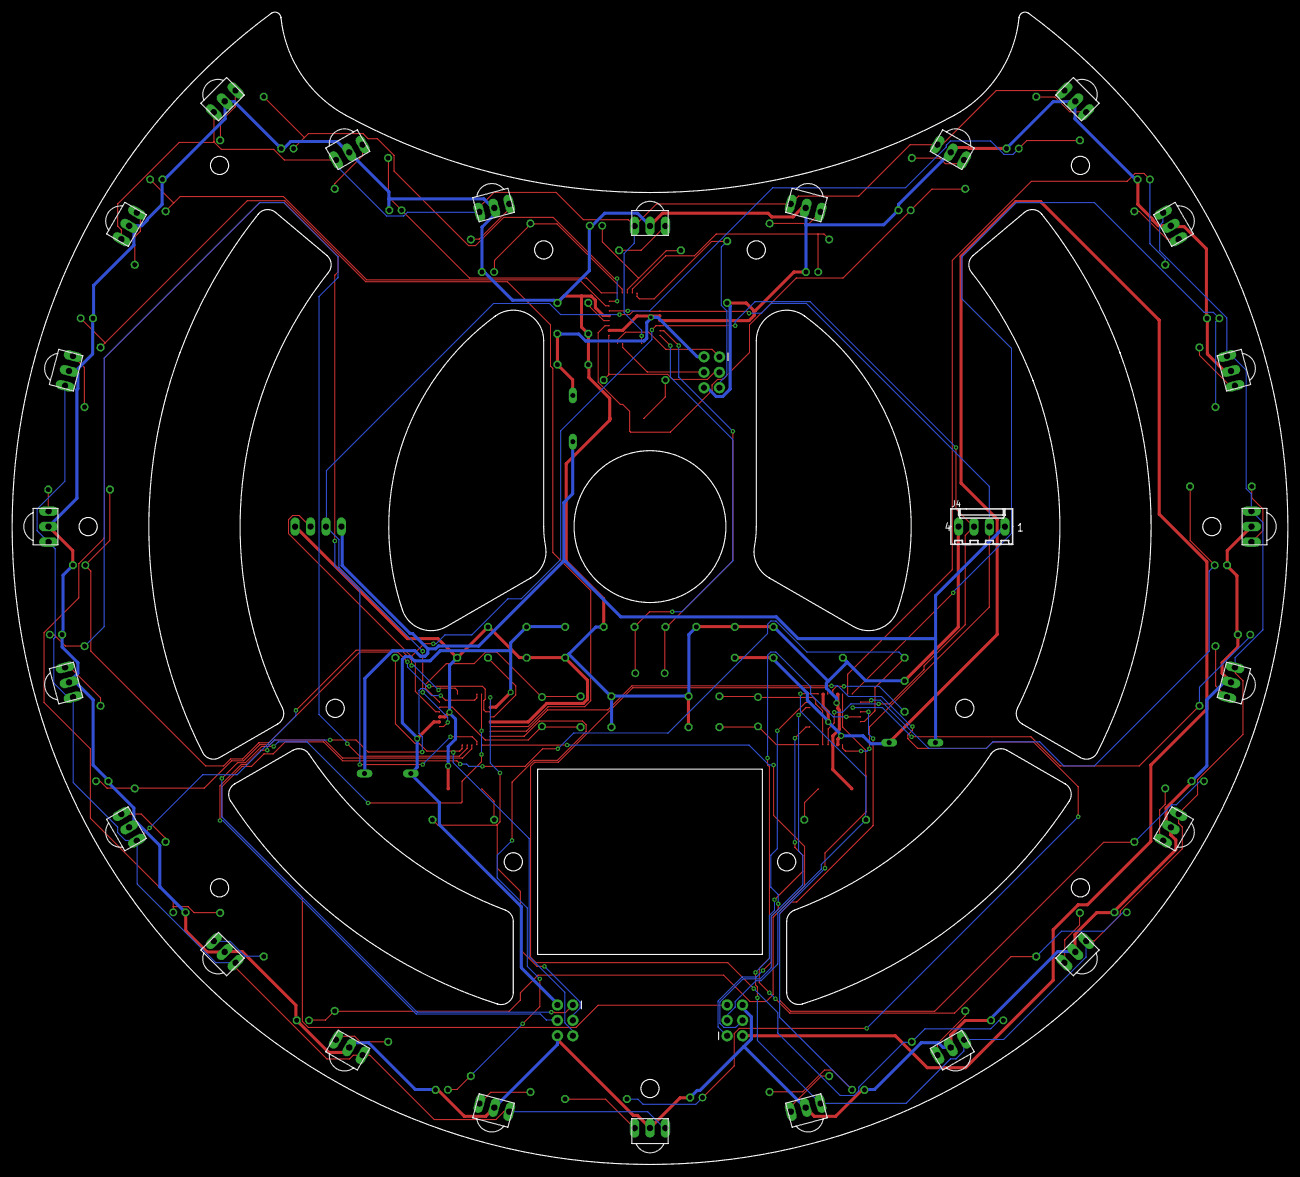
[picture p20: board Board 2.brd from below]

Board: 2 copper layers, 210.0 x 189.7 mm, 110 parts (25 on the bottom side), 82 nets.
