SFXSoccer/ABCDEFC-Soccer-Robot/EAGLE/Projects 2019/2019 Soccer Robot/Board 1.brd

## EAGLE design EAGLE/Projects 2019/2019 Soccer Robot/Board 1.brd (2019-07-01)

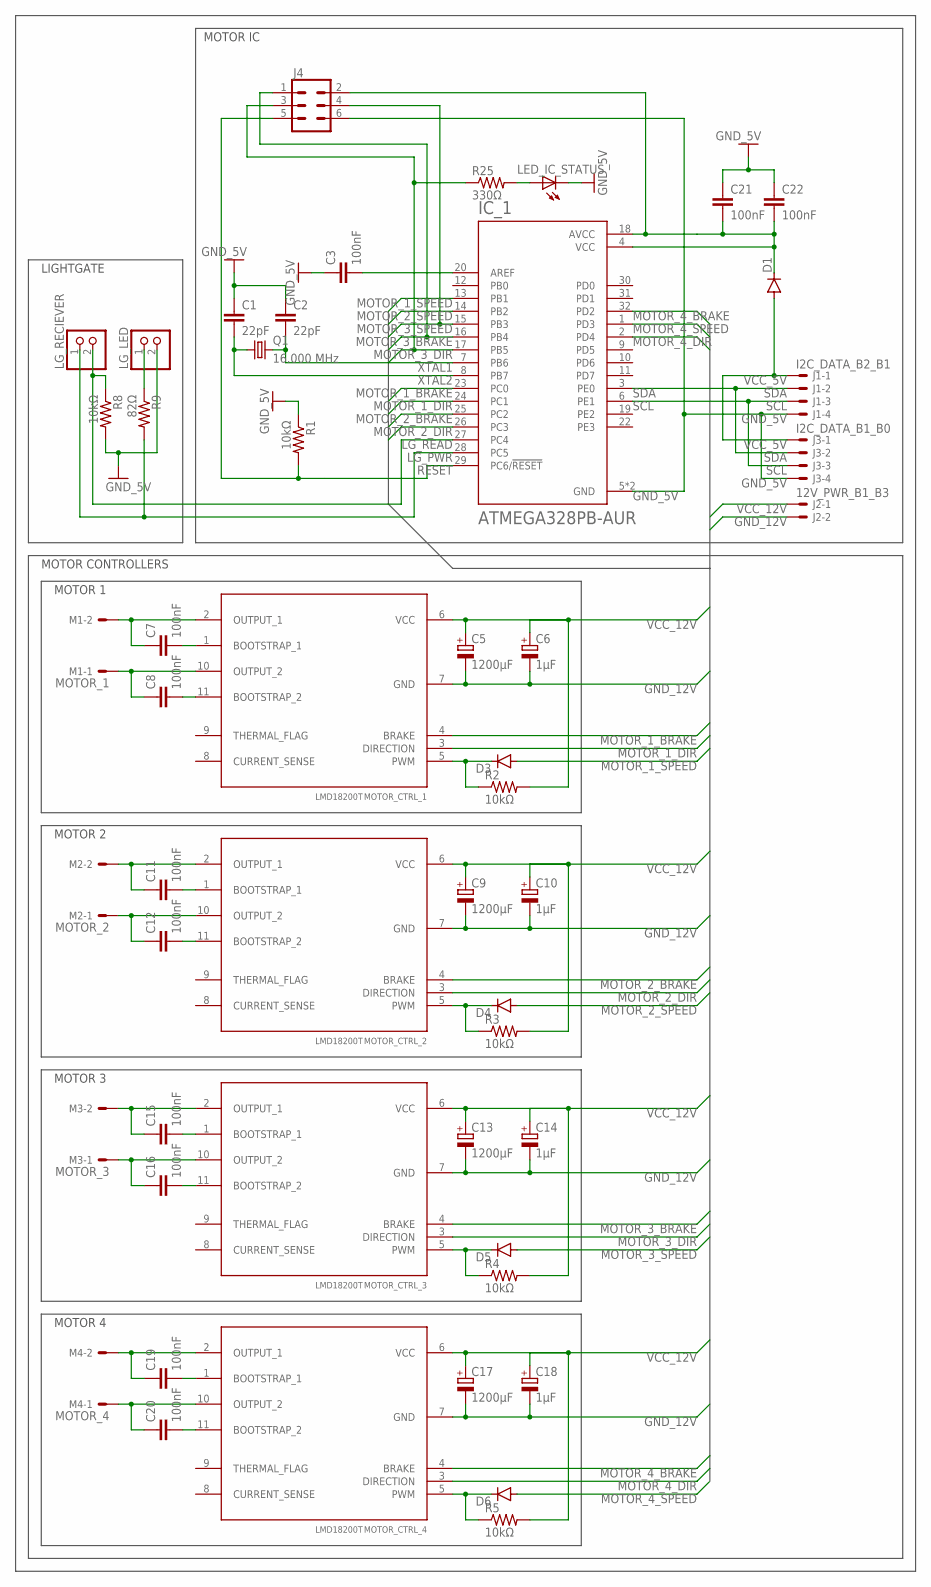
[picture p21: schematic Board 1.sch]

Parts:
C1, C2: 22pF; C050-024X044
C3, C7, C8, C11, C12, C15, C16, C19, C20, C21, C22: 100nF; C050-024X044
C5, C9, C13, C17: 1200µF; E5-13
C6, C10, C14, C18: 1μF; E2-5
D1, D3, D4, D5, D6: 1N4148DO35-7; DO35-7
IC_1: ATMEGA328PB-AUR; QFP80P900X900X120-32N
J1: I2C_DATA_B2_B1; 6410-04
J2: 12V_PWR_B1_B3; 6410-02
J3: I2C_DATA_B1_B0; 6410-04
J4: CONN_03X2SHROUD; 2X3-SHROUDED
LED_IC_STATUS: LEDP-LCC-2; P-LCC-2
LG_LED: PINHD-1X2; 1X02
LG_RECIEVER: PINHD-1X2; 1X02
M1: MOTOR_1; 6410-02
M2: MOTOR_2; 6410-02
M3: MOTOR_3; 6410-02
M4: MOTOR_4; 6410-02
MOTOR_CTRL_1, MOTOR_CTRL_2, MOTOR_CTRL_3, MOTOR_CTRL_4: LMD18200T; TO-220-11
Q1: 16.000 MHz; HC49U-V
R1, R2, R3, R4, R5, R8: 10kΩ; 0207/10
R9: 82Ω; 0207/10
R25: 330Ω; 0207/10

Connections:
GND_5V: C1.1, C2.1, C3.1, C21.1, C22.1, IC_1.5 (GND), IC_1.21 (GND), J1.4, J3.4, J4.6, LED_IC_STATUS.C, LG_LED.2, R1.1, R8.2
GND_12V: C5.-, C6.-, C9.-, C10.-, C13.-, C14.-, C17.-, C18.-, J2.2, MOTOR_CTRL_1.7 (GND), MOTOR_CTRL_2.7 (GND), MOTOR_CTRL_3.7 (GND), MOTOR_CTRL_4.7 (GND)
LG_PWR: IC_1.28 (PC5), LG_RECIEVER.1, R9.2
LG_READ: IC_1.27 (PC4), LG_RECIEVER.2, R8.1
MOTOR_1_BRAKE: IC_1.23 (PC0), MOTOR_CTRL_1.4 (BRAKE)
MOTOR_1_DIR: IC_1.24 (PC1), MOTOR_CTRL_1.3 (DIRECTION)
MOTOR_1_SPEED: D3.A, IC_1.13 (PB1)
MOTOR_2_BRAKE: IC_1.25 (PC2), MOTOR_CTRL_2.4 (BRAKE)
MOTOR_2_DIR: IC_1.26 (PC3), MOTOR_CTRL_2.3 (DIRECTION)
MOTOR_2_SPEED: D4.A, IC_1.14 (PB2)
MOTOR_3_BRAKE: IC_1.16 (PB4), J4.1, MOTOR_CTRL_3.4 (BRAKE)
MOTOR_3_DIR: IC_1.17 (PB5), J4.3, MOTOR_CTRL_3.3 (DIRECTION), R25.1
MOTOR_3_SPEED: D5.A, IC_1.15 (PB3), J4.4
MOTOR_4_BRAKE: IC_1.32 (PD2), MOTOR_CTRL_4.4 (BRAKE)
MOTOR_4_DIR: IC_1.2 (PD4), MOTOR_CTRL_4.3 (DIRECTION)
MOTOR_4_SPEED: D6.A, IC_1.1 (PD3)
unnamed: C3.2, IC_1.20 (AREF)
unnamed: LG_LED.1, R9.1
unnamed: LED_IC_STATUS.A, R25.2
unnamed: D3.C, MOTOR_CTRL_1.5 (PWM), R2.1
unnamed: C7.1, M1.2, MOTOR_CTRL_1.2 (OUTPUT_1)
unnamed: C21.2, C22.2, D1.C, IC_1.4 (VCC), IC_1.18 (AVCC), J4.2
unnamed: C8.1, M1.1, MOTOR_CTRL_1.10 (OUTPUT_2)
unnamed: C8.2, MOTOR_CTRL_1.11 (BOOTSTRAP_2)
unnamed: C7.2, MOTOR_CTRL_1.1 (BOOTSTRAP_1)
unnamed: D4.C, MOTOR_CTRL_2.5 (PWM), R3.1
unnamed: C11.1, M2.2, MOTOR_CTRL_2.2 (OUTPUT_1)
unnamed: C12.1, M2.1, MOTOR_CTRL_2.10 (OUTPUT_2)
unnamed: C12.2, MOTOR_CTRL_2.11 (BOOTSTRAP_2)
unnamed: C11.2, MOTOR_CTRL_2.1 (BOOTSTRAP_1)
unnamed: D5.C, MOTOR_CTRL_3.5 (PWM), R4.1
unnamed: C15.1, M3.2, MOTOR_CTRL_3.2 (OUTPUT_1)
unnamed: C16.1, M3.1, MOTOR_CTRL_3.10 (OUTPUT_2)
unnamed: C16.2, MOTOR_CTRL_3.11 (BOOTSTRAP_2)
unnamed: C15.2, MOTOR_CTRL_3.1 (BOOTSTRAP_1)
unnamed: D6.C, MOTOR_CTRL_4.5 (PWM), R5.1
unnamed: C19.1, M4.2, MOTOR_CTRL_4.2 (OUTPUT_1)
unnamed: C20.1, M4.1, MOTOR_CTRL_4.10 (OUTPUT_2)
unnamed: C20.2, MOTOR_CTRL_4.11 (BOOTSTRAP_2)
unnamed: C19.2, MOTOR_CTRL_4.1 (BOOTSTRAP_1)
RESET: IC_1.29 (PC6/!RESET), J4.5, R1.2
SCL: IC_1.6 (PE1), J1.3, J3.3
SDA: IC_1.3 (PE0), J1.2, J3.2
VCC_5V: D1.A, J1.1, J3.1
VCC_12V: C5.+, C6.+, C9.+, C10.+, C13.+, C14.+, C17.+, C18.+, J2.1, MOTOR_CTRL_1.6 (VCC), MOTOR_CTRL_2.6 (VCC), MOTOR_CTRL_3.6 (VCC), MOTOR_CTRL_4.6 (VCC), R2.2, R3.2, R4.2, R5.2
XTAL1: C2.2, IC_1.7 (PB6), Q1.2
XTAL2: C1.2, IC_1.8 (PB7), Q1.1

Notes on the sheet:
MOTOR 1
MOTOR 2
MOTOR 3
MOTOR 4
MOTOR CONTROLLERS
MOTOR IC
LIGHTGATE

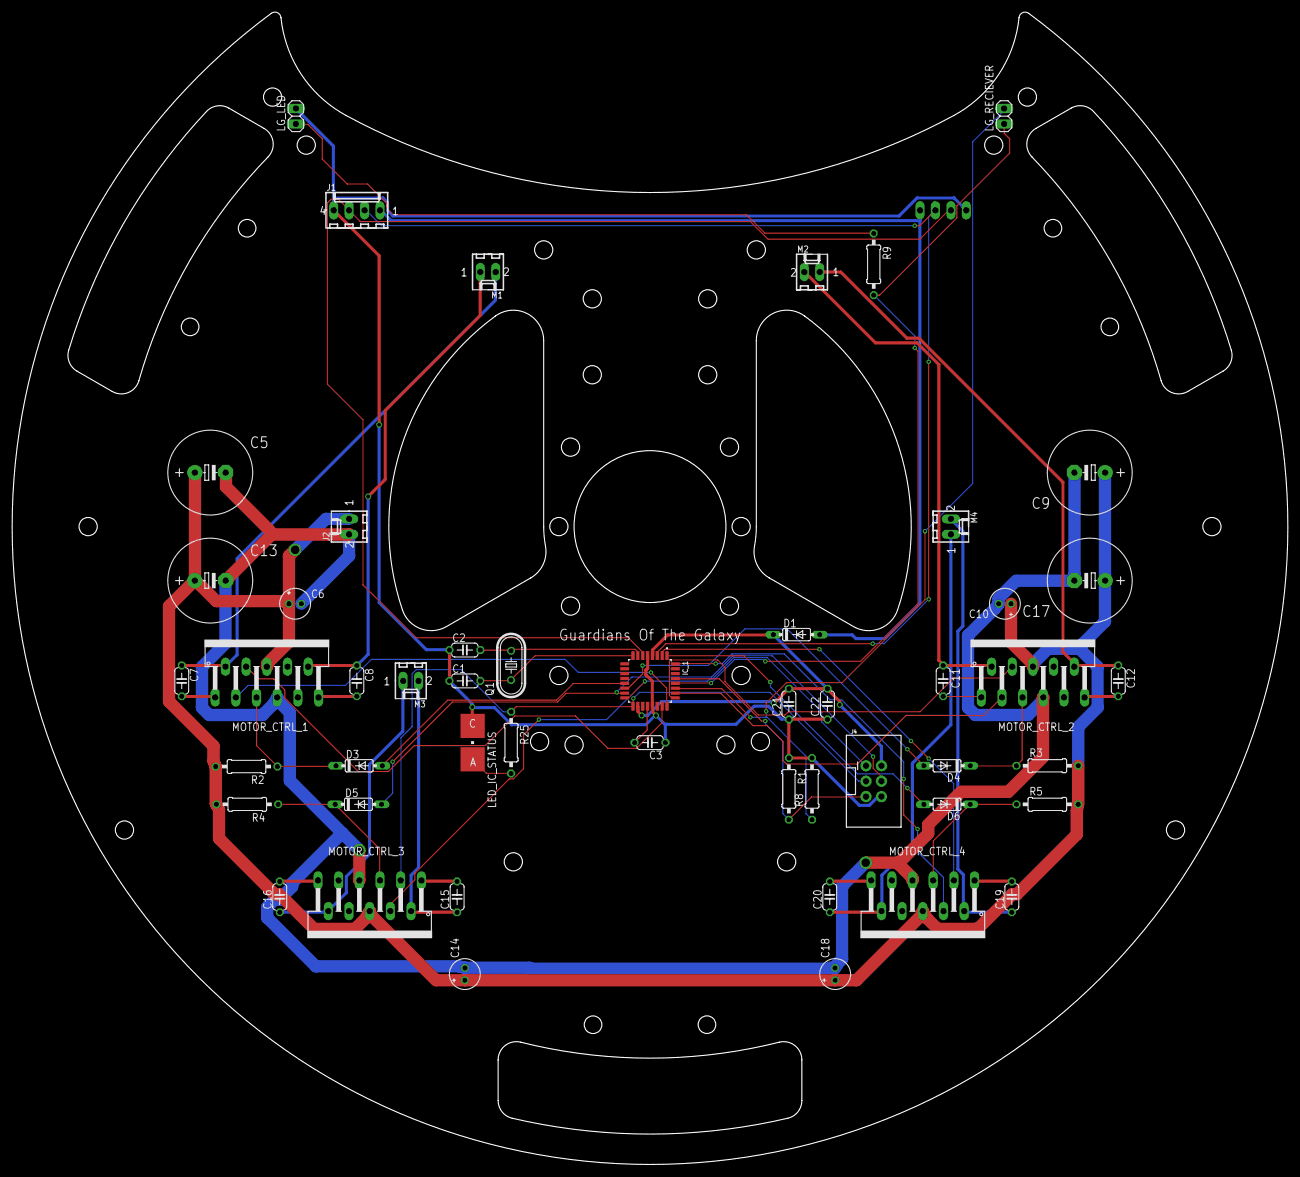
[picture p22: board Board 1.brd from above]

Board: 2 copper layers, 210.0 x 189.7 mm, 51 parts (1 on the bottom side), 47 nets.
