SFXSoccer/ABCDEFC-Soccer-Robot/EAGLE/Projects 2019/2019 Soccer Robot/Board 0.brd

## EAGLE design EAGLE/Projects 2019/2019 Soccer Robot/Board 0.brd (2019-07-01)

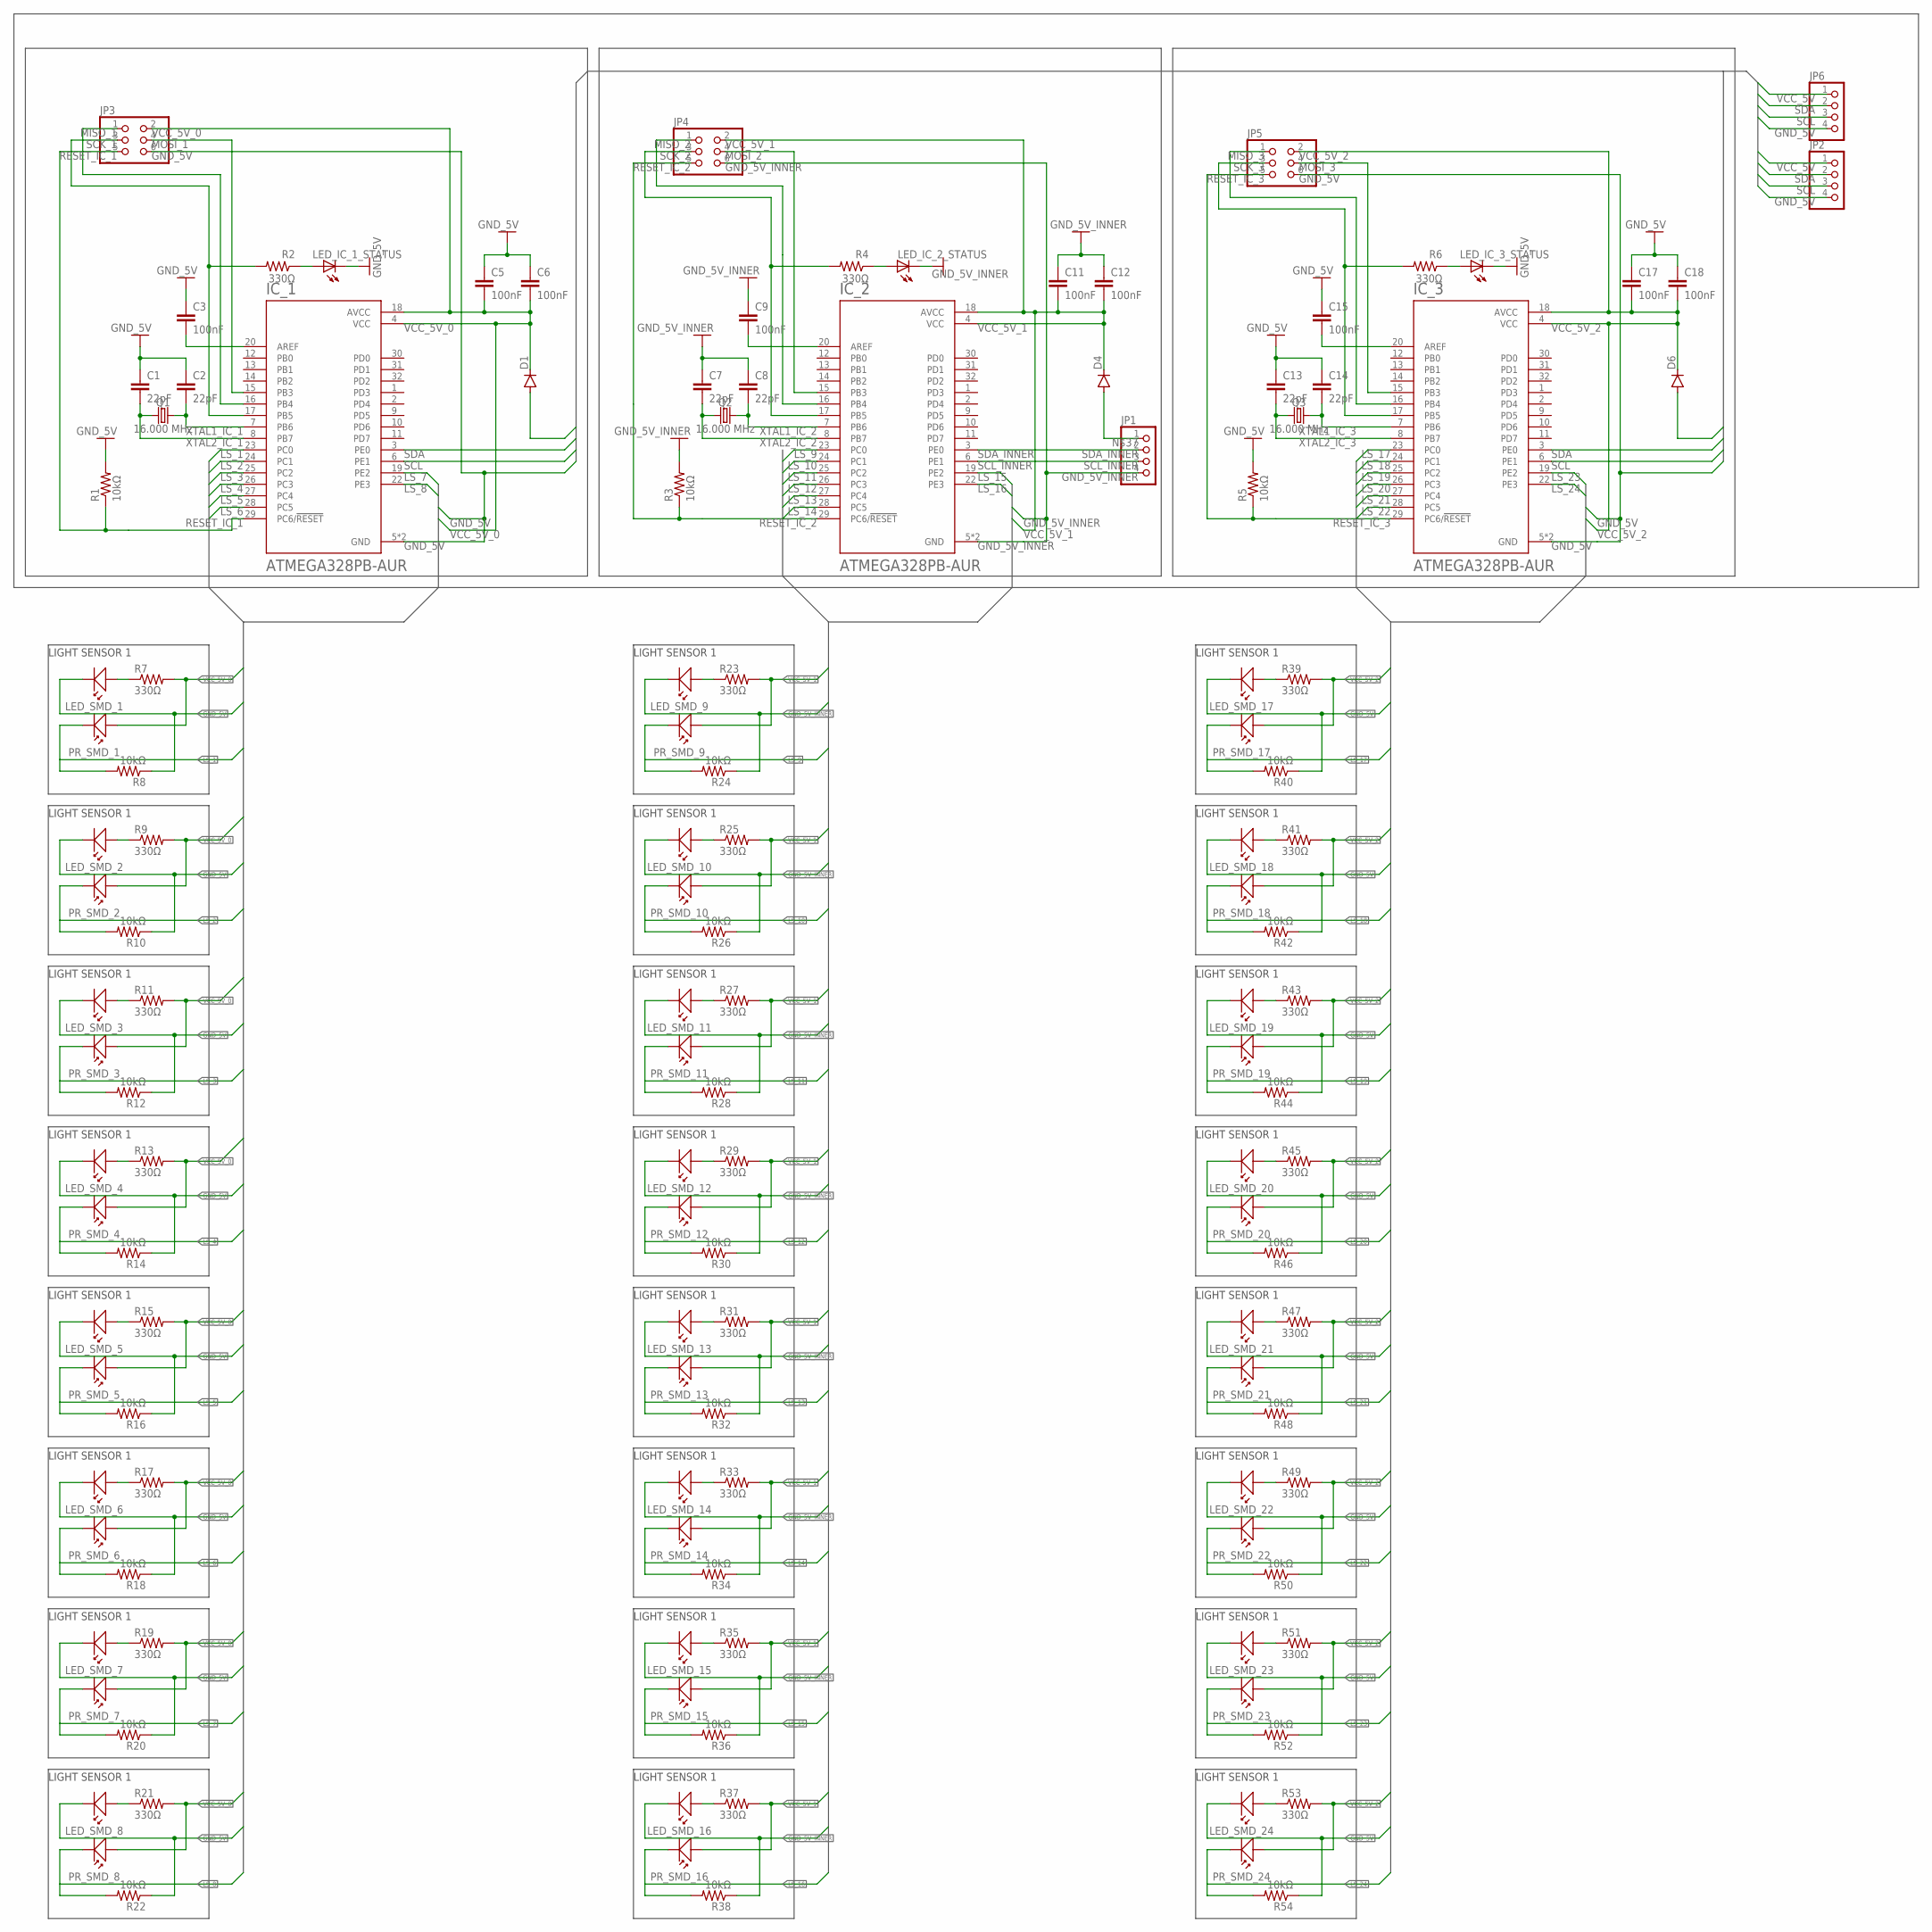
[picture p23: schematic Board 0.sch]

Parts:
C1, C2, C7, C8, C13, C14: 22pF; C1206
C3, C5, C6, C9, C11, C12, C15, C17, C18: 100nF; C1206
D1, D4, D6: DIODE-SOD123; SOD123
IC_1, IC_2, IC_3: ATMEGA328PB-AUR; QFP80P900X900X120-32N
JP1, JP2, JP6: PINHD-1X4_2.54-SMD; 1X04SMD
JP3, JP4, JP5: PINHD-2X3_2.54-SMD; 2X03SMD
LED_IC_1_STATUS, LED_IC_2_STATUS, LED_IC_3_STATUS: LEDP-LCC-2; P-LCC-2
LED_SMD_1, LED_SMD_2, LED_SMD_3, LED_SMD_4, LED_SMD_5, LED_SMD_6, LED_SMD_7, LED_SMD_8, LED_SMD_9, LED_SMD_10, LED_SMD_11, LED_SMD_12, LED_SMD_13, LED_SMD_14, LED_SMD_15, LED_SMD_16, LED_SMD_17, LED_SMD_18, LED_SMD_19, LED_SMD_20, LED_SMD_21, LED_SMD_22, LED_SMD_23, LED_SMD_24: SMD_LED_3MM
PR_SMD_1, PR_SMD_2, PR_SMD_3, PR_SMD_4, PR_SMD_5, PR_SMD_6, PR_SMD_7, PR_SMD_8, PR_SMD_9, PR_SMD_10, PR_SMD_11, PR_SMD_12, PR_SMD_13, PR_SMD_14, PR_SMD_15, PR_SMD_16, PR_SMD_17, PR_SMD_18, PR_SMD_19, PR_SMD_20, PR_SMD_21, PR_SMD_22, PR_SMD_23, PR_SMD_24: SMD_PHOTORESISTOR_5MM
Q1, Q2, Q3: 16.000 MHz; CRYSTAL-SMD-5X3.2-4PAD
R1, R3, R5, R8, R10, R12, R14, R16, R18, R20, R22, R24, R26, R28, R30, R32, R34, R36, R38, R40, R42, R44, R46, R48, R50, R52, R54: 10kΩ; R1206
R2, R4, R6, R7, R9, R11, R13, R15, R17, R19, R21, R23, R25, R27, R29, R31, R33, R35, R37, R39, R41, R43, R45, R47, R49, R51, R53: 330Ω; R1206

Connections:
GND_5V: C1.1, C2.1, C3.1, C5.1, C6.1, C13.1, C14.1, C15.1, C17.1, C18.1, IC_1.5 (GND), IC_1.21 (GND), IC_3.5 (GND), IC_3.21 (GND), JP2.4, JP3.6, JP5.6, JP6.4, LED_IC_1_STATUS.C, LED_IC_3_STATUS.C, LED_SMD_1.GND, LED_SMD_2.GND, LED_SMD_3.GND, LED_SMD_4.GND, LED_SMD_5.GND, LED_SMD_6.GND, LED_SMD_7.GND, LED_SMD_8.GND, LED_SMD_17.GND, LED_SMD_18.GND, LED_SMD_19.GND, LED_SMD_20.GND, LED_SMD_21.GND, LED_SMD_22.GND, LED_SMD_23.GND, LED_SMD_24.GND, R1.2, R5.2, R8.1, R10.1, R12.1, R14.1, R16.1, R18.1, R20.1, R22.1, R40.1, R42.1, R44.1, R46.1, R48.1, R50.1, R52.1, R54.1
GND_5V_INNER: C7.1, C8.1, C9.1, C11.1, C12.1, IC_2.5 (GND), IC_2.21 (GND), JP1.4, JP4.6, LED_IC_2_STATUS.C, LED_SMD_9.GND, LED_SMD_10.GND, LED_SMD_11.GND, LED_SMD_12.GND, LED_SMD_13.GND, LED_SMD_14.GND, LED_SMD_15.GND, LED_SMD_16.GND, R3.2, R24.1, R26.1, R28.1, R30.1, R32.1, R34.1, R36.1, R38.1
LS_1: IC_1.23 (PC0), PR_SMD_1.GND, R8.2
LS_2: IC_1.24 (PC1), PR_SMD_2.GND, R10.2
LS_3: IC_1.25 (PC2), PR_SMD_3.GND, R12.2
LS_4: IC_1.26 (PC3), PR_SMD_4.GND, R14.2
LS_5: IC_1.27 (PC4), PR_SMD_5.GND, R16.2
LS_6: IC_1.28 (PC5), PR_SMD_6.GND, R18.2
LS_7: IC_1.19 (PE2), PR_SMD_7.GND, R20.2
LS_8: IC_1.22 (PE3), PR_SMD_8.GND, R22.2
LS_9: IC_2.23 (PC0), PR_SMD_9.GND, R24.2
LS_10: IC_2.24 (PC1), PR_SMD_10.GND, R26.2
LS_11: IC_2.25 (PC2), PR_SMD_11.GND, R28.2
LS_12: IC_2.26 (PC3), PR_SMD_12.GND, R30.2
LS_13: IC_2.27 (PC4), PR_SMD_13.GND, R32.2
LS_14: IC_2.28 (PC5), PR_SMD_14.GND, R34.2
LS_15: IC_2.19 (PE2), PR_SMD_15.GND, R36.2
LS_16: IC_2.22 (PE3), PR_SMD_16.GND, R38.2
LS_17: IC_3.23 (PC0), PR_SMD_17.GND, R40.2
LS_18: IC_3.24 (PC1), PR_SMD_18.GND, R42.2
LS_19: IC_3.25 (PC2), PR_SMD_19.GND, R44.2
LS_20: IC_3.26 (PC3), PR_SMD_20.GND, R46.2
LS_21: IC_3.27 (PC4), PR_SMD_21.GND, R48.2
LS_22: IC_3.28 (PC5), PR_SMD_22.GND, R50.2
LS_23: IC_3.19 (PE2), PR_SMD_23.GND, R52.2
LS_24: IC_3.22 (PE3), PR_SMD_24.GND, R54.2
MISO_1: IC_1.16 (PB4), JP3.1
MISO_2: IC_2.16 (PB4), JP4.1
MISO_3: IC_3.16 (PB4), JP5.1
MOSI_1: IC_1.15 (PB3), JP3.4
MOSI_2: IC_2.15 (PB3), JP4.4
MOSI_3: IC_3.15 (PB3), JP5.4
unnamed: C3.2, IC_1.20 (AREF)
unnamed: LED_IC_1_STATUS.A, R2.1
unnamed: LED_SMD_2.VIN, R9.1
unnamed: C9.2, IC_2.20 (AREF)
unnamed: LED_IC_2_STATUS.A, R4.1
unnamed: LED_SMD_3.VIN, R11.1
unnamed: LED_SMD_4.VIN, R13.1
unnamed: C15.2, IC_3.20 (AREF)
unnamed: LED_IC_3_STATUS.A, R6.1
unnamed: LED_SMD_1.VIN, R7.1
unnamed: LED_SMD_5.VIN, R15.1
unnamed: LED_SMD_6.VIN, R17.1
unnamed: LED_SMD_7.VIN, R19.1
unnamed: LED_SMD_8.VIN, R21.1
unnamed: LED_SMD_9.VIN, R23.1
unnamed: LED_SMD_10.VIN, R25.1
unnamed: LED_SMD_11.VIN, R27.1
unnamed: LED_SMD_12.VIN, R29.1
unnamed: LED_SMD_13.VIN, R31.1
unnamed: LED_SMD_14.VIN, R33.1
unnamed: LED_SMD_15.VIN, R35.1
unnamed: LED_SMD_16.VIN, R37.1
unnamed: LED_SMD_17.VIN, R39.1
unnamed: LED_SMD_18.VIN, R41.1
unnamed: LED_SMD_19.VIN, R43.1
unnamed: LED_SMD_20.VIN, R45.1
unnamed: LED_SMD_21.VIN, R47.1
unnamed: LED_SMD_22.VIN, R49.1
unnamed: LED_SMD_23.VIN, R51.1
unnamed: LED_SMD_24.VIN, R53.1
unnamed: D4.A, JP1.1
RESET_IC_1: IC_1.29 (PC6/!RESET), JP3.5, R1.1
RESET_IC_2: IC_2.29 (PC6/!RESET), JP4.5, R3.1
RESET_IC_3: IC_3.29 (PC6/!RESET), JP5.5, R5.1
SCK_1: IC_1.17 (PB5), JP3.3, R2.2
SCK_2: IC_2.17 (PB5), JP4.3, R4.2
SCK_3: IC_3.17 (PB5), JP5.3, R6.2
SCL: IC_1.6 (PE1), IC_3.6 (PE1), JP2.3, JP6.3
SCL_INNER: IC_2.6 (PE1), JP1.3
SDA: IC_1.3 (PE0), IC_3.3 (PE0), JP2.2, JP6.2
SDA_INNER: IC_2.3 (PE0), JP1.2
VCC_5V: D1.A, D6.A, JP2.1, JP6.1
VCC_5V_0: C5.2, C6.2, D1.C, IC_1.4 (VCC), IC_1.18 (AVCC), JP3.2, PR_SMD_1.VIN, PR_SMD_2.VIN, PR_SMD_3.VIN, PR_SMD_4.VIN, PR_SMD_5.VIN, PR_SMD_6.VIN, PR_SMD_7.VIN, PR_SMD_8.VIN, R7.2, R9.2, R11.2, R13.2, R15.2, R17.2, R19.2, R21.2
VCC_5V_1: C11.2, C12.2, D4.C, IC_2.4 (VCC), IC_2.18 (AVCC), JP4.2, PR_SMD_9.VIN, PR_SMD_10.VIN, PR_SMD_11.VIN, PR_SMD_12.VIN, PR_SMD_13.VIN, PR_SMD_14.VIN, PR_SMD_15.VIN, PR_SMD_16.VIN, R23.2, R25.2, R27.2, R29.2, R31.2, R33.2, R35.2, R37.2
VCC_5V_2: C17.2, C18.2, D6.C, IC_3.4 (VCC), IC_3.18 (AVCC), JP5.2, PR_SMD_17.VIN, PR_SMD_18.VIN, PR_SMD_19.VIN, PR_SMD_20.VIN, PR_SMD_21.VIN, PR_SMD_22.VIN, PR_SMD_23.VIN, PR_SMD_24.VIN, R39.2, R41.2, R43.2, R45.2, R47.2, R49.2, R51.2, R53.2
XTAL1_IC_1: C2.2, IC_1.7 (PB6), Q1.3 (2)
XTAL1_IC_2: C8.2, IC_2.7 (PB6), Q2.3 (2)
XTAL1_IC_3: C14.2, IC_3.7 (PB6), Q3.3 (2)
XTAL2_IC_1: C1.2, IC_1.8 (PB7), Q1.1
XTAL2_IC_2: C7.2, IC_2.8 (PB7), Q2.1
XTAL2_IC_3: C13.2, IC_3.8 (PB7), Q3.1

Notes on the sheet:
LIGHT SENSOR 1

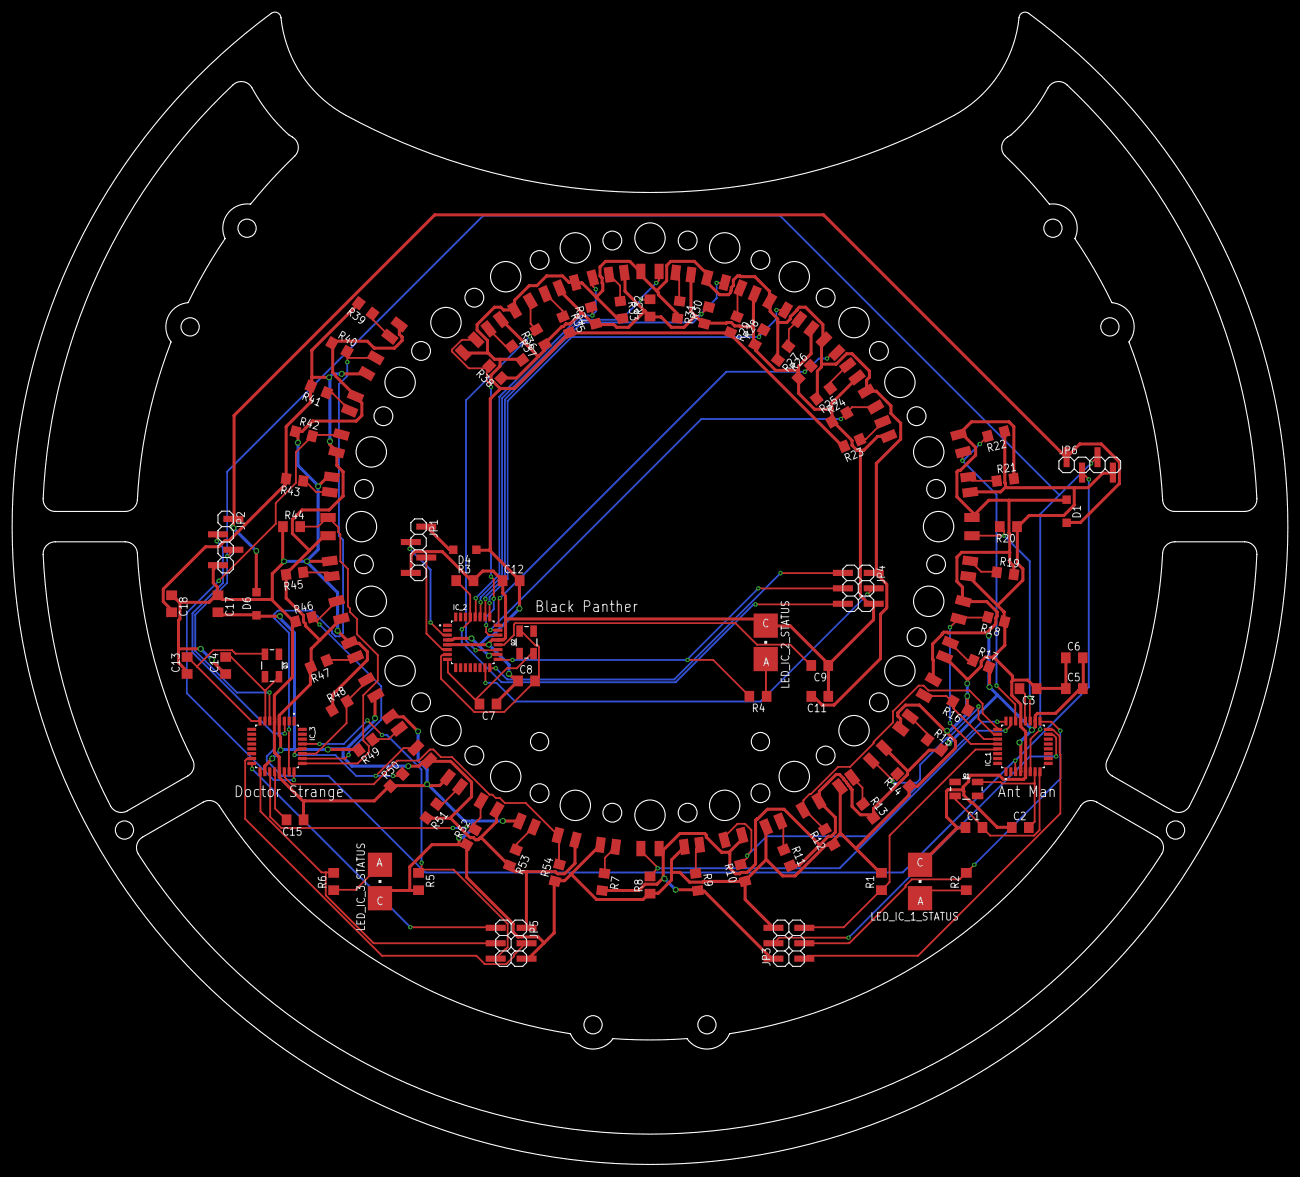
[picture p24: board Board 0.brd from above]

Board: 2 copper layers, 210.0 x 189.7 mm, 135 parts (0 on the bottom side), 83 nets.
