SFXSoccer/ABCDEFC-Soccer-Robot/EAGLE/Projects 2019/2019 Soccer Robot/Board 3 Teensy.brd

## EAGLE design EAGLE/Projects 2019/2019 Soccer Robot/Board 3 Teensy.brd (2019-07-01)

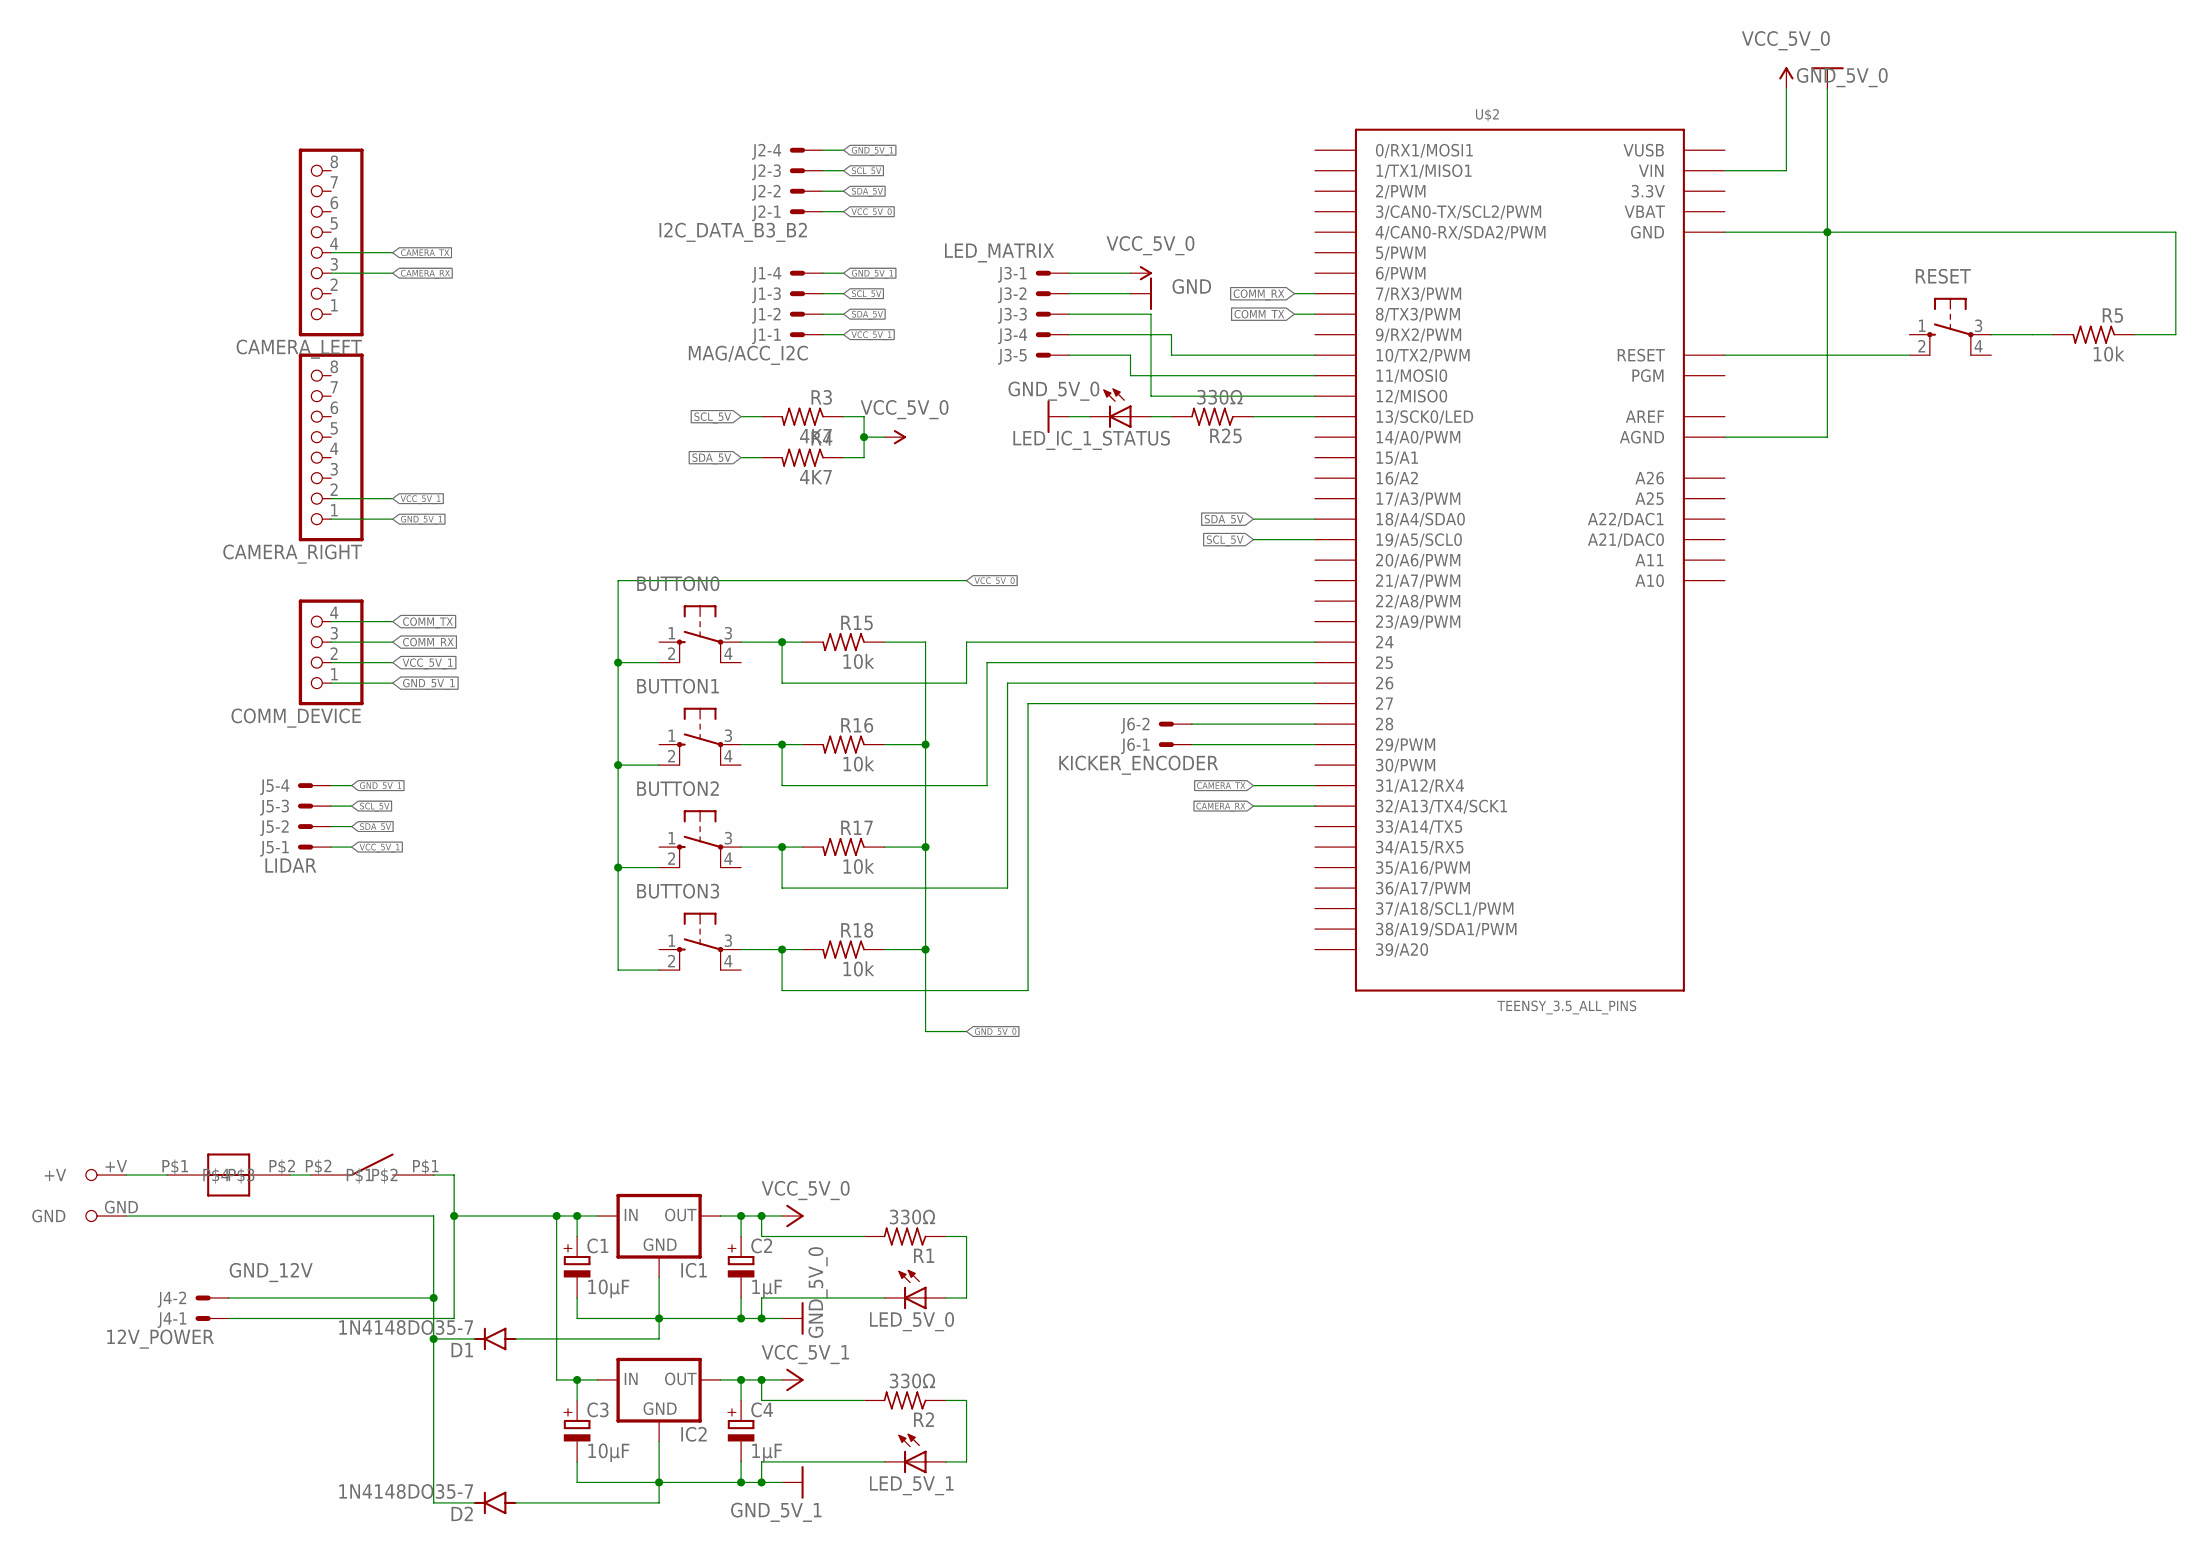
[picture p25: schematic Board 3 Teensy.sch]

Parts:
BUTTON0, BUTTON1, BUTTON2, BUTTON3: 10-XX; B3F-10XX
C1, C3: 10μF; E2-5
C2, C4: 1μF; E2-5
CAMERA_LEFT: PINHD-1X8; 1X08
CAMERA_RIGHT: PINHD-1X8; 1X08
COMM_DEVICE: PINHD-1X4; 1X04
D1, D2: 1N4148DO35-7; DO35-7
IC1, IC2: 78XXS
J1: MAG/ACC_I2C; 6410-04
J2: I2C_DATA_B3_B2; 6410-04
J3: LED_MATRIX; 6410-05
J4: 12V_POWER; 6410-02
J5: LIDAR; 6410-04
J6: KICKER_ENCODER; 6410-02
LED_5V_0, LED_5V_1: LEDP-LCC-2; P-LCC-2
LED_IC_1_STATUS: LEDP-LCC-2; P-LCC-2
R1, R2, R25: 330Ω; 0207/10
R3, R4: 4K7; 0207/9
R5, R15, R16, R17, R18: 10k; 0207/9
RESET: 10-XX; B3F-10XX
SICHERUNG1: SICHERUNG
U$1: XT60
U$2: TEENSY_3.5_ALL_PINS
U$17: SCHALTER

Connections:
3.3V: U$2.3.3V, U$2.3.3V3 (3.3V), U$2.3.3V4 (3.3V)
+12V: C1.+, C3.+, IC1.IN, IC2.IN, J4.1, U$17.P$1
AREF: U$2.AREF
BUTTON_0: BUTTON0.3, R15.2, U$2.24
CAMERA_RX: CAMERA_LEFT.3, U$2.32/A13 (32/A13/TX4/SCK1)
CAMERA_TX: CAMERA_LEFT.4, U$2.31/A12 (31/A12/RX4)
COMM_RX: COMM_DEVICE.3, U$2.7 (7/RX3/PWM)
COMM_TX: COMM_DEVICE.4, U$2.8 (8/TX3/PWM)
GND: J3.2
GND_5V_0: C1.-, C2.-, D1.A, IC1.GND, LED_5V_0.C, LED_IC_1_STATUS.C, R5.1, R15.1, R16.1, R17.1, R18.1, U$2.AGND, U$2.GND, U$2.GND1 (GND), U$2.GND3 (GND), U$2.GND4 (GND), U$2.GND6 (GND)
GND_5V_1: C3.-, C4.-, CAMERA_RIGHT.1, COMM_DEVICE.1, D2.A, IC2.GND, J1.4, J2.4, J5.4, LED_5V_1.C
GND_12V: D1.C, D2.C, J4.2, U$1.GND
unnamed: SICHERUNG1.P$1, U$1.+V
unnamed: SICHERUNG1.P$2, U$17.P$2
unnamed: R25.1, U$2.13 (13/SCK0/LED)
unnamed: J3.3, U$2.12 (12/MISO0)
unnamed: J3.4, U$2.10 (10/TX2/PWM)
unnamed: J3.5, U$2.11 (11/MOSI0)
unnamed: BUTTON1.3, R16.2, U$2.25
unnamed: BUTTON2.3, R17.2, U$2.26
unnamed: LED_5V_1.A, R2.1
unnamed: LED_5V_0.A, R1.1
unnamed: BUTTON3.3, R18.2, U$2.27
unnamed: J6.2, U$2.28
unnamed: J6.1, U$2.29 (29/PWM)
unnamed: RESET.2 (S1), U$2.RESET
unnamed: R5.2, RESET.3
unnamed: LED_IC_1_STATUS.A, R25.2
SCL_5V: J1.3, J2.3, J5.3, R3.2, U$2.19/A5 (19/A5/SCL0)
SDA_5V: J1.2, J2.2, J5.2, R4.2, U$2.18/A4 (18/A4/SDA0)
VBAT: U$2.VBAT
VCC_5V_0: BUTTON0.2 (S1), BUTTON1.2 (S1), BUTTON2.2 (S1), BUTTON3.2 (S1), C2.+, IC1.OUT, J2.1, J3.1, R1.2, R3.1, R4.1, U$2.VIN
VCC_5V_1: C4.+, CAMERA_RIGHT.2, COMM_DEVICE.2, IC2.OUT, J1.1, J5.1, R2.2
VUSB: U$2.VUSB

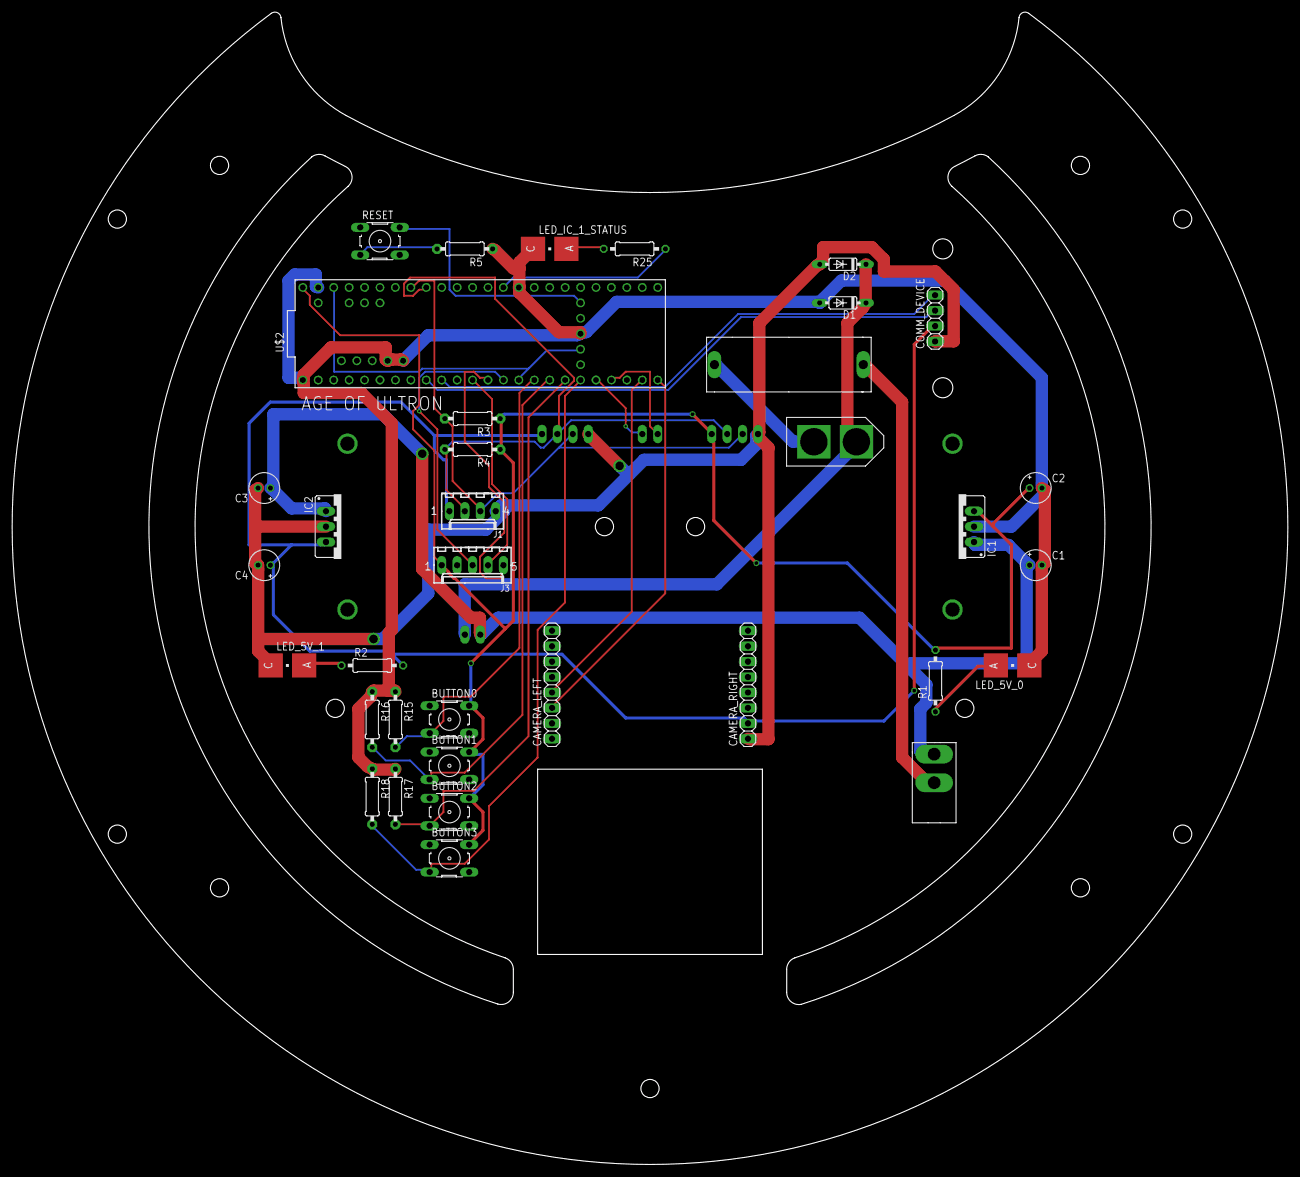
[picture p26: board Board 3 Teensy.brd from above]

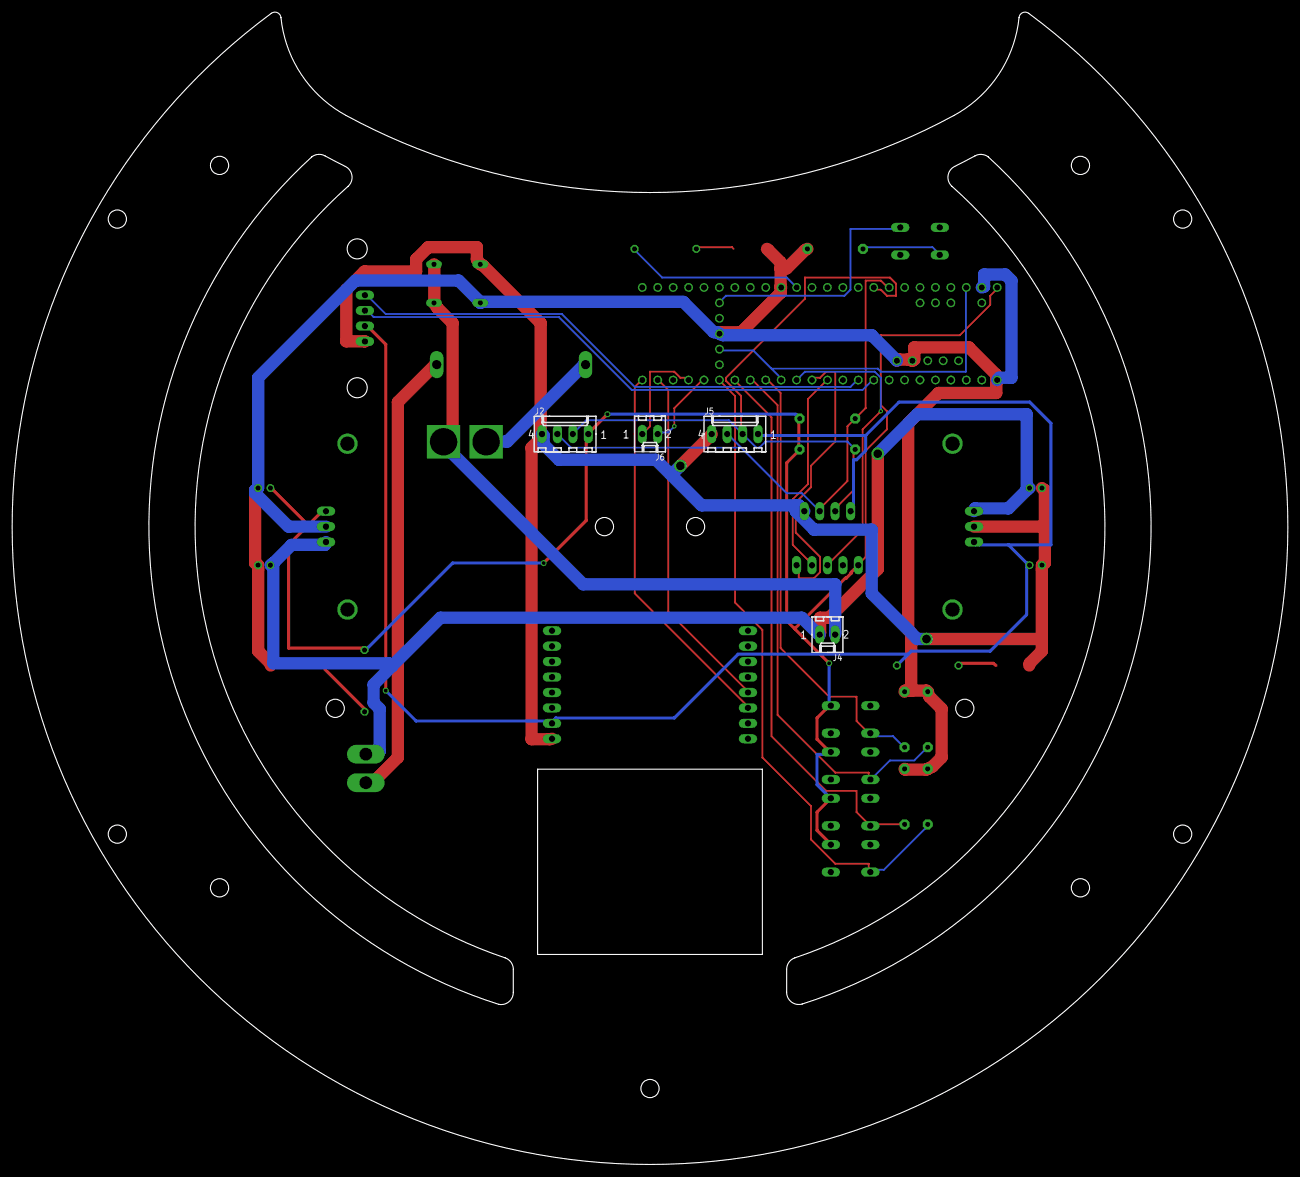
[picture p27: board Board 3 Teensy.brd from below]

Board: 2 copper layers, 210.0 x 189.7 mm, 41 parts (4 on the bottom side), 30 nets.

Other parts of the board:
U$5, U$9: STAND-OFF
