SFXSoccer/ABCDEFC-Soccer-Robot/EAGLE/Projects 2019/2019 Soccer Robot/Board 3.brd

## EAGLE design EAGLE/Projects 2019/2019 Soccer Robot/Board 3.brd (2019-07-01)

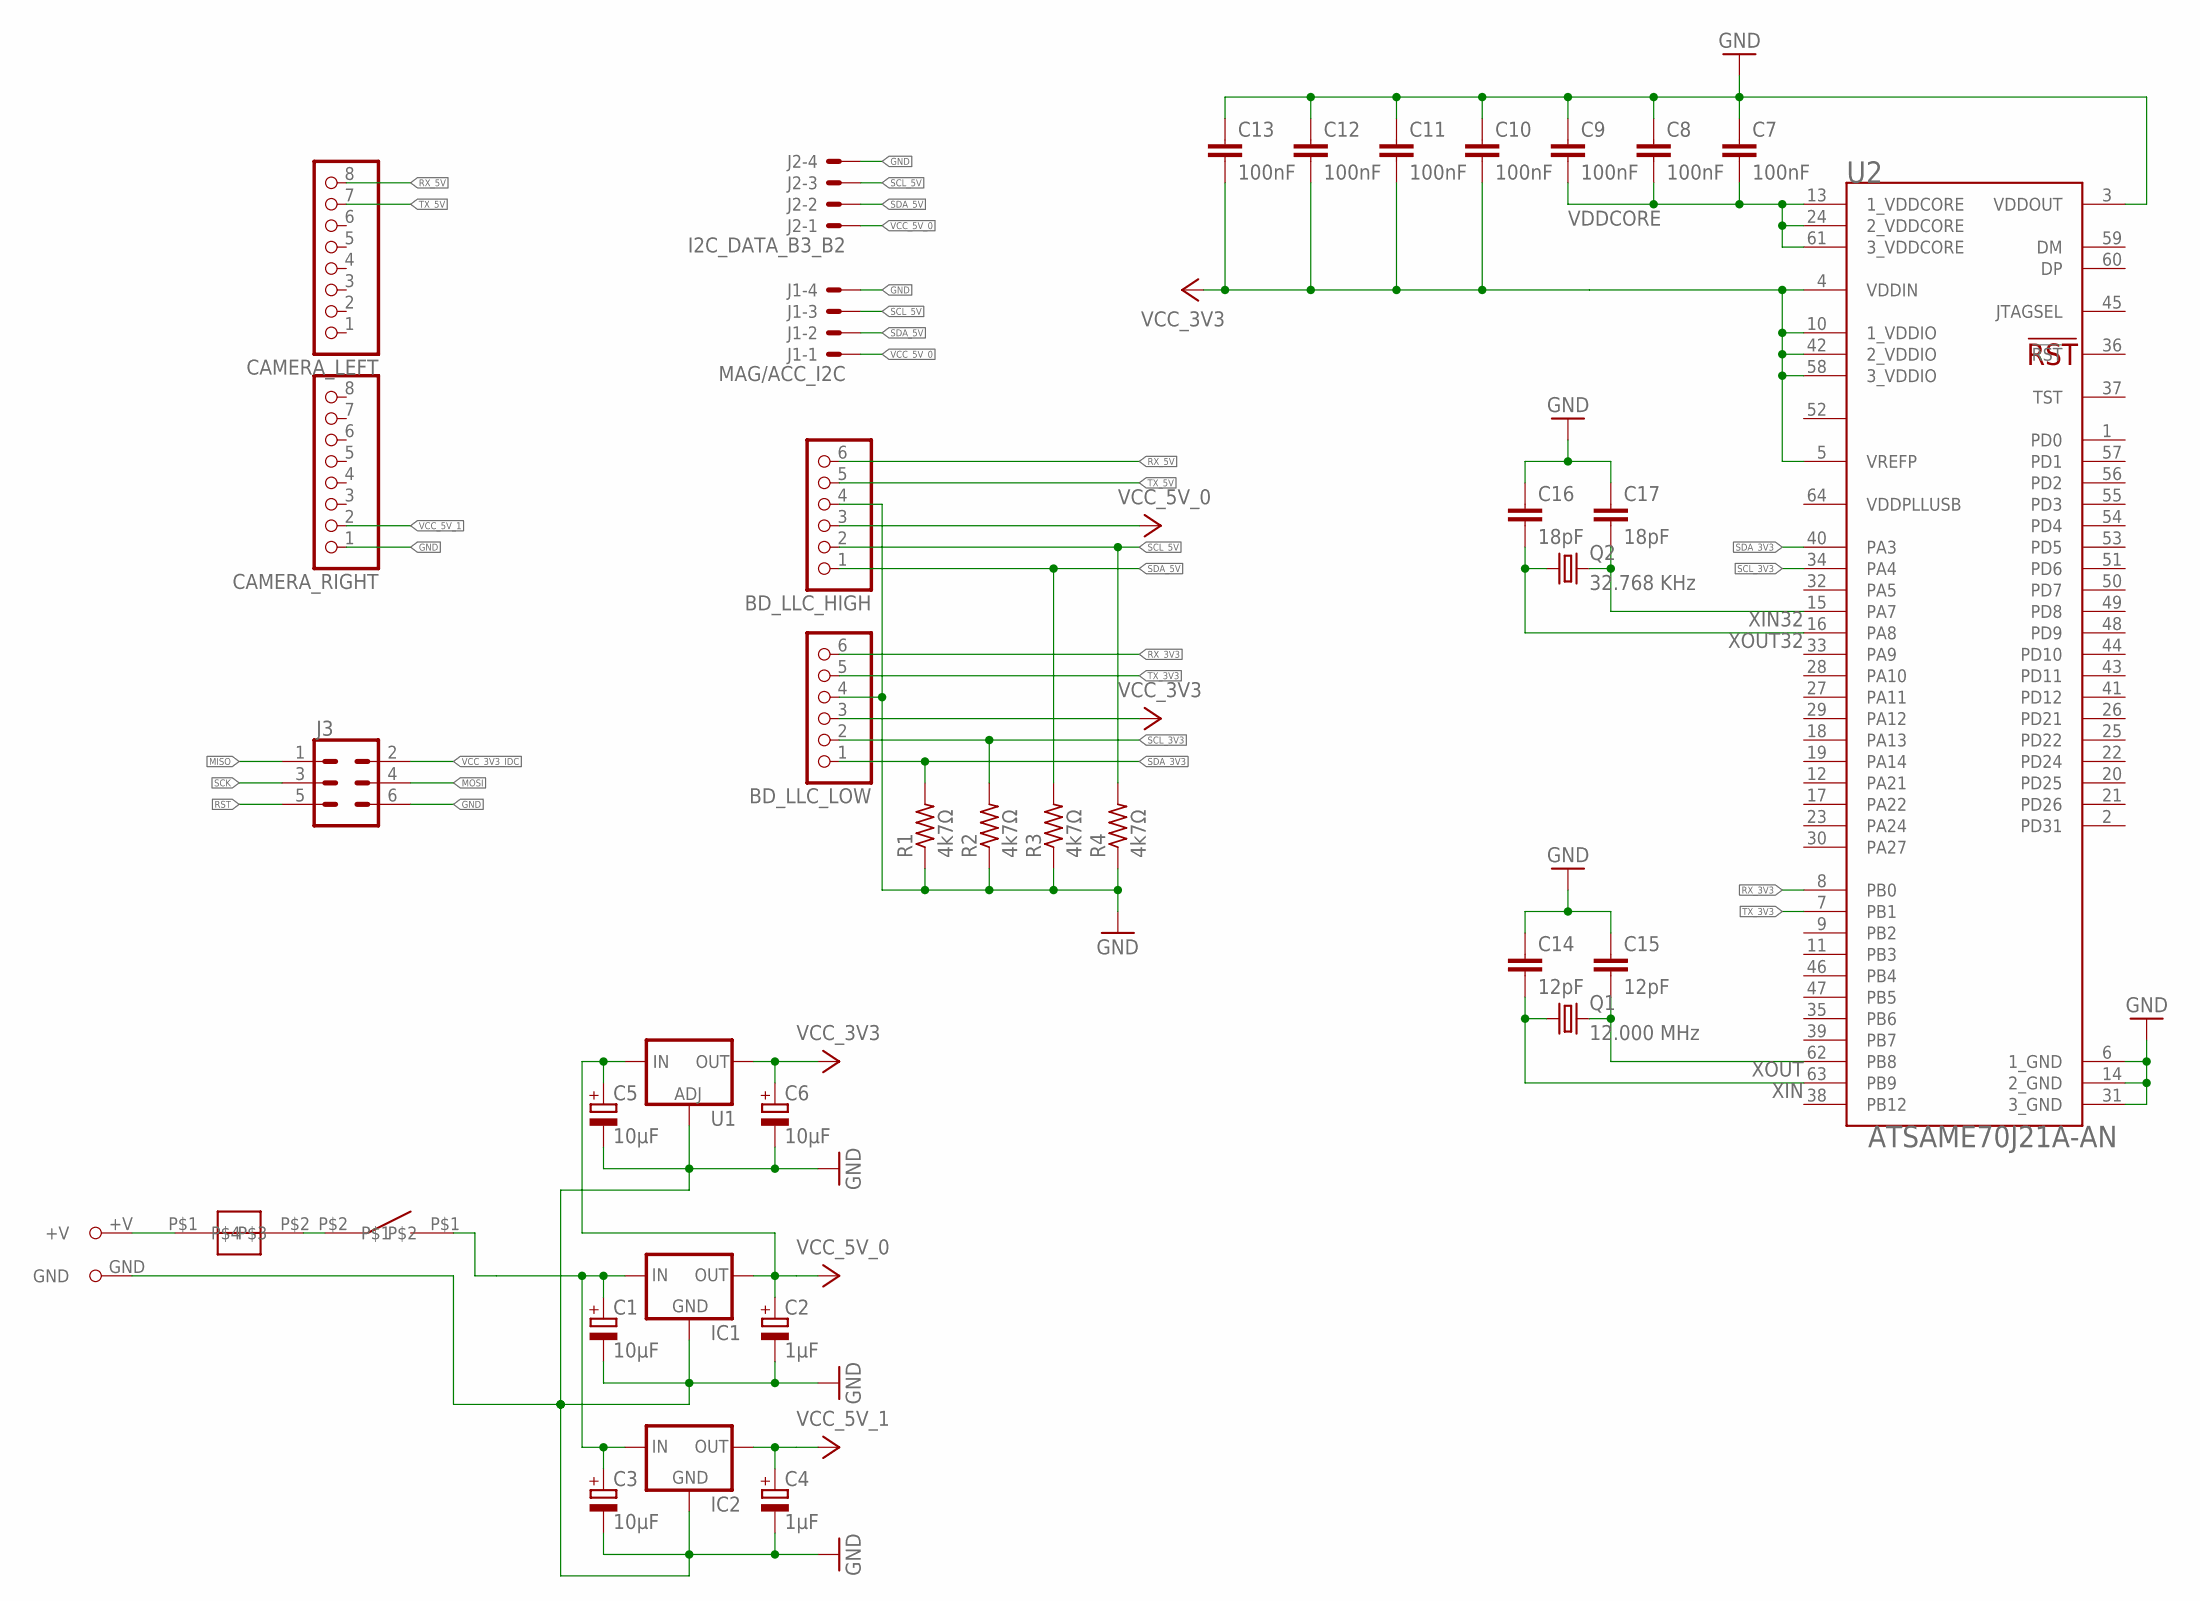
[picture p28: schematic Board 3.sch]

Parts:
BD_LLC_HIGH: PINHD-1X6; 1X06
BD_LLC_LOW: PINHD-1X6; 1X06
C1, C3, C5, C6: 10μF; E2-5
C2, C4: 1μF; E2-5
C7, C8, C9, C10, C11, C12, C13: 100nF; C050-024X044
C14, C15: 12pF; C050-024X044
C16, C17: 18pF; C050-024X044
CAMERA_LEFT: PINHD-1X8; 1X08
CAMERA_RIGHT: PINHD-1X8; 1X08
IC1, IC2: 78XXS
J1: MAG/ACC_I2C; 6410-04
J2: I2C_DATA_B3_B2; 6410-04
J3: CONN_03X2SHROUD; 2X3-SHROUDED
Q1: 12.000 MHz; HC49U-V
Q2: 32.768 KHz; TC26V
R1, R2, R3, R4: 4k7Ω; 0207/10
SICHERUNG1: SICHERUNG
U1: V_REG_LM1117SOT223; SOT223
U2: ATMEL_CORPORATION_ATSAME70J21A-ANATMEL_CORPORATIO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; ATMEL_CORPORATION_ATSAME70J21A-AN_0
U$1: XT60
U$17: SCHALTER

Connections:
+12V: C1.+, C3.+, IC1.IN, IC2.IN, U$17.P$1
GND: BD_LLC_HIGH.4, BD_LLC_LOW.4, C1.-, C2.-, C3.-, C4.-, C5.-, C6.-, C7.1, C8.1, C9.1, C10.1, C11.1, C12.1, C13.1, C14.1, C15.1, C16.1, C17.1, CAMERA_RIGHT.1, IC1.GND, IC2.GND, J1.4, J2.4, J3.6, R1.1, R2.1, R3.1, R4.1, U1.1 (ADJ), U2.3 (VDDOUT), U2.6 (1_GND), U2.14 (2_GND), U2.31 (3_GND), U$1.GND
MISO: J3.1
MOSI: J3.4
unnamed: SICHERUNG1.P$1, U$1.+V
unnamed: SICHERUNG1.P$2, U$17.P$2
RST: J3.5
RX_3V3: BD_LLC_LOW.6, U2.8 (PB0)
RX_5V: BD_LLC_HIGH.6, CAMERA_LEFT.8
SCK: J3.3
SCL_3V3: BD_LLC_LOW.2, R2.2, U2.34 (PA4)
SCL_5V: BD_LLC_HIGH.2, J1.3, J2.3, R4.2
SDA_3V3: BD_LLC_LOW.1, R1.2, U2.40 (PA3)
SDA_5V: BD_LLC_HIGH.1, J1.2, J2.2, R3.2
TX_3V3: BD_LLC_LOW.5, U2.7 (PB1)
TX_5V: BD_LLC_HIGH.5, CAMERA_LEFT.7
VCC_3V3: BD_LLC_LOW.3, C6.+, C10.2, C11.2, C12.2, C13.2, U1.2 (OUT), U1.4 (OUT), U2.4 (VDDIN), U2.5 (VREFP), U2.10 (1_VDDIO), U2.42 (2_VDDIO), U2.58 (3_VDDIO)
VCC_3V3_IDC: J3.2
VCC_5V_0: BD_LLC_HIGH.3, C2.+, C5.+, IC1.OUT, J1.1, J2.1, U1.3 (IN)
VCC_5V_1: C4.+, CAMERA_RIGHT.2, IC2.OUT
VDDCORE: C7.2, C8.2, C9.2, U2.13 (1_VDDCORE), U2.24 (2_VDDCORE), U2.61 (3_VDDCORE)
XIN: C14.2, Q1.1, U2.63 (PB9)
XIN32: C17.2, Q2.2, U2.15 (PA7)
XOUT: C15.2, Q1.2, U2.62 (PB8)
XOUT32: C16.2, Q2.1, U2.16 (PA8)

Board: 2 copper layers, 37 parts (1 on the bottom side), 20 nets, no tracks yet.
