SFXSoccer/ABCDEFC-Soccer-Robot/Programming/Arduino/Robot V2/Robot/src/Robot/Core.h

#pragma once

#include <Arduino.h>
#include <SoftwareSerial.h>
#include <Wire.h>

#include "Utils/Error.h"
#include "Utils/Timer.h"
#include "Utils/EventTimer.h"

#pragma region General

#define I2C_CONNECTION_TIMEOUT		1000
#define COMMUNICATION_TIMEOUT		1000

#define SENSOR_I2C_DELAY_MS			1
#define SENSOR_I2C_DELAY_MICRO		30

#define SENSOR_LIGHT_DATA_COUNT		8
#define SENSOR_TSOP_DATA_COUNT		8

#define DELAY_STATUS_LED_WAIT		1000
#define DELAY_STATUS_LED_ERROR		50
#define DELAY_STATUS_LED_DIAGNOSIS	200
#define DELAY_DIAGNOSTIC_SEND		100

#define MOTOR_1						0x00
#define MOTOR_2						0x01
#define MOTOR_3						0x02
#define MOTOR_4						0x03

#define PIVOT_1						0x01
#define PIVOT_2						0x02
#define PIVOT_3						0x03

#define MOTOR_DIR_FORWARD			0x01
#define MOTOR_DIR_REVERSE			0x00

#define COMM_PACKET_SIZE			6
#define COMM_PACKET_VERIFY			0xFF
#define COMM_PACKET_START			0xFE
#define COMM_PACKET_END				0xFD

#define CAMERA_DATA_BYTE_COUNT		10
#define CAMERA_GOAL_NOT_FOUND		255

#define CAMERA_IMAGE_WIDTH			160
#define CAMERA_IMAGE_HEIGHT			120

#pragma endregion

#pragma region Commands

#define CMD_DIAGNOSTIC_START		0xA5
#define CMD_DIAGNOSTIC_STOP			0xA6
#define CMD_DIAGNOSTIC_I2C_SCAN		0xA7

#define CMD_MOTOR					0x15
#define CMD_LIGHTGATE				0x16
#define CMD_CAMERA					0xC5

#pragma endregion
