SFXSoccer/ABCDEFC-Soccer-Robot/(commit log)

2019-07-01 Initial Project Push
    [0207_10, 0207_10_44.ipt, 0207_10, 0207_10_61.ipt, 0207_10, 0207_10_70.ipt, 0207_9, 10K_50.ipt, 0207_9, 4K7_47.ipt, 1X02, 1X02_43.ipt, 1X04, 1X04_17.ipt, 1X04SMD, JP1_1X04SMD_27.ipt]
2019-07-01 Inventor Files
    [15mmStandoff.ipt, 19mmStandoff.ipt, 1stPlate.ipt, 2ndPlate.ipt, 2x6mmScrew.ipt, 3rdFront.ipt, 3rdPlate.ipt, 3rdShroud.ipt]
2019-07-04 Fixed a bug with the motors
    [LightSensorController.h, SoccerRobot.ino]
